Williangalvani/pfc/electronics.tex

\chapter{The Electronics} \label{chap:electronics}

In order for the aircraft to fly and navigate autonomously, onboard electronics are required, for both actuation, power source, and navigation. Some of the used electronics were already available, and were chosen for this reason. Others were chosen taking into account technical specifications, price, and availability.
	
\section{Propulsion}

Due to the familiarity and availability, the Mikrokopter Mk3638 Motor was chosen, paired with E-Max Simon 60A escs.

Experimental curves for the motor are available at Mikrokopter's website, and the relevant ones are reproduced in figure \ref{fig:motorcurves}. Each motor should give, on 16 V, around 1.9 kg of static thrust when paired to 12 inches propellers, up to 2.5 kg on 15 inches, while drawing 35 A, or about 560 W.

\begin{figure}[H]
\centering
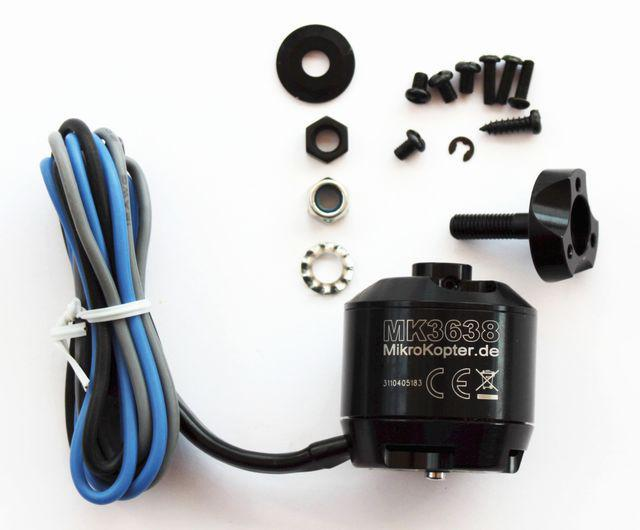
[picture p5: figs/mk3638.jpg]
  
  \caption{Mikrokopter MK3638 Brushless Motor.}
  \label{fig:mk3638}
\end{figure}

\begin{figure}[h]
  \centering
  \begin{subfigure}{0.9\textwidth}
    \centering
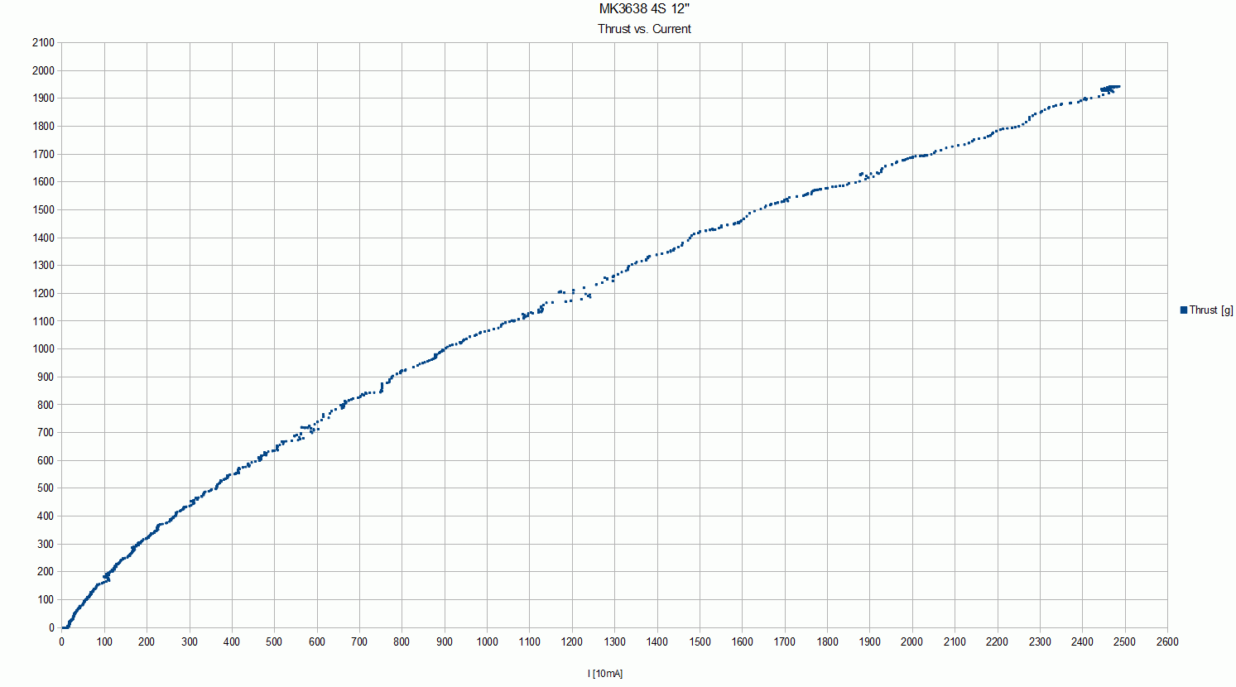
[picture p6: figs/curve12.png]
    
  
  \end{subfigure}
  
  \begin{subfigure}{0.9\textwidth}
    \centering
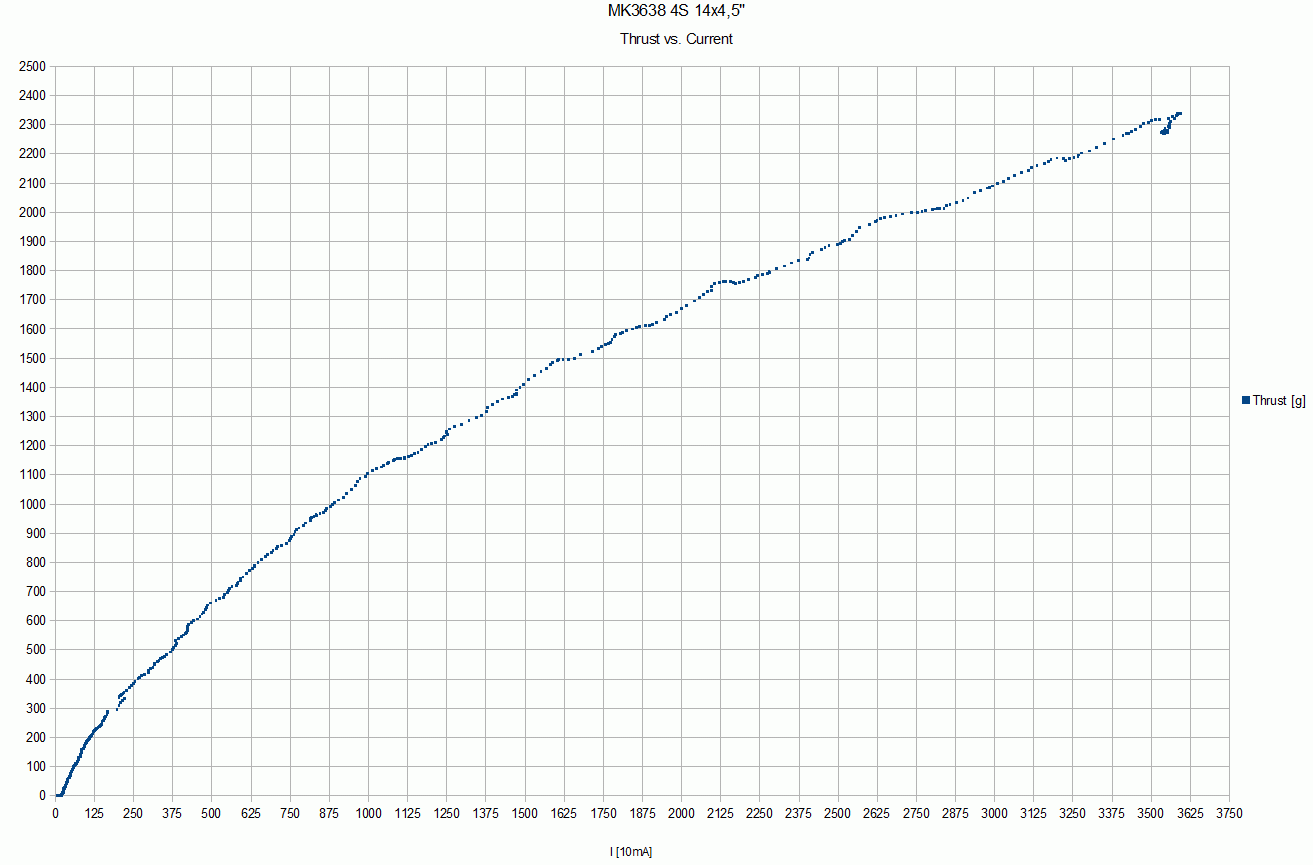
[picture p7: figs/curve15.png]
    

  \end{subfigure}
  \caption{Motor curves with 12 and 15 inches propellers. Source: mikrokopter.de}
  \label{fig:motorcurves}
\end{figure}

\begin{table}[H]
\centering
\begin{tabular}{|l|l|}
\hline
Lithium cell count 					& 3-6 \\ \hline
Load current      					& max. 20A \\ \hline
Maximum load current. (60 sec)		& 25 A \\ \hline
No-load speed 						& 770 rpm / V \\ \hline
Recommended Propeller Size 			& 10" .. 14" \\ \hline
Mechanical power					& 350 W \\ \hline
Thrust max.							& 2200 g \\ \hline
Wire length							& about 52 cm \\ \hline
Total weight (without cable)		& approx 100g \\ \hline
Dimensions							& h=35mm, d=38mm \\ \hline
Shaft diameter						& 4 mm \\ \hline
\end{tabular}
\caption{Mk3638 Brushless Motor Technical Specifications}\label{tab:mk3638}
\end{table}

As the airplane is aimed to weigh around 3 kg, each motor needs to pull at least 1500g for hovering, leaving a maneuvering margin of around 1 kg for each motor.

\section{Batteries}

As each motor can draw up to 25 A, the battery should be able to provide up to 50 A without issues.
The Batteries chosen are also the ones already in use by the company, Multistars 10000 mAh 10C, which, at 10 C rating, are able to sustain a constant draw of up to 100 A. 

Each battery weighs approximately 800 g and measures 160 x 65 x 36 mm.

\begin{table}[h]
\centering
\caption{Multistar 4s 10000mAh Battery Technical Specifications}
\label{tab:multistar}
\begin{tabular}{|l|l|}
\hline
Minimum Capacity		& 10000mAh \\ \hline
Configuration			& 4S1P / 14.8V / 4Cell \\ \hline
Constant Discharge		& 10C \\ \hline
Peak Discharge (10sec)	& 20C \\ \hline
Pack Weight				& 804g \\ \hline
Pack Size				& 160 x 65 x 36mm \\ \hline
Charge Plug				& JST-XH \\ \hline
Discharge Plug			& XT90 \\ \hline
\end{tabular}
\end{table}

\begin{figure}[H]
\centering
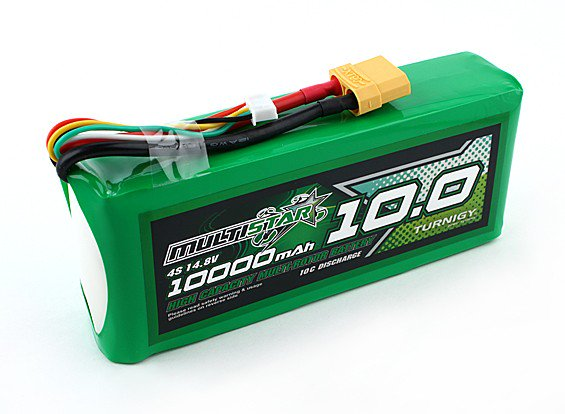
[picture p8: figs/battery.jpg]
  
  \caption{Multistar 4s 10000 mAh Lithium Polymer battery.}
  \label{fig:multistar}
\end{figure}

\section{The Servos and Control Surfaces}

The control surfaces must be slightly larger than usual for a flying wing, as on a tail-sitter a reasonable amount of air must be deflected on hover situation, while on most wings a steady airflow is assumed. It is suggested to have control surfaces taking up to 30\% of the chord of the wings. Since they are easily swappable, it was decided to start with smaller ones, with a 10 cm chord, and replace them if necessary.

The servos chosen were standard servos Savox SV-0220, linked to the elevon horns with a stiff wire. %\todo{add picture of horns}

\begin{figure}[H]
\centering
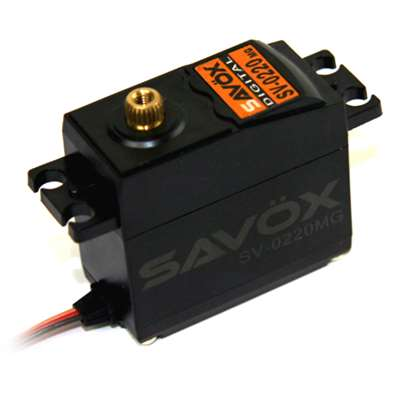
[picture p9: figs/servo.jpg]
  
  \caption{Savox SV-0220 servo.}
  \label{fig:sv-0220}
\end{figure}

\begin{table}[h]
\centering
\caption{SV-0220 Technical Specifications}
\label{my-label}
\begin{tabular}{|l|l|}
\hline
 Torque @ 6v &   6.5kg  \\ \hline
 Torque @ 7.4v & 8.0kg  \\ \hline
 Speed @ 6v    &  0.16 sec/60 deg  \\ \hline
 Speed @ 7.4v  &  0.13 sec/60 deg  \\ \hline
 Dimensions L x W x H (mm) &  40.7 x 20.0 x 37.0   \\ \hline
 Weight & 59.0g   \\ \hline
\end{tabular}
\end{table}

\section{The Flight Controller}

The multirotor had a huge boom in the last 10 years. In 2009 the first hobby-grade flight controller for multicopters was born, Rolf "KaptainKuk" Bakke's "KK board". Using a simple AVR controller and three gyroscopes, the board could control angular speed on three axis, enabling pilots to control the multirotors. It was programmed in AVR assembly and had individual PID controllers for each axis.
%
Shortly after, Alexinparis noticed the gyros on the Wii Motion + controller, and MultiWii was born. This project grew to support a variety of sensors and boards, and had an active development community, but has now saturated the AVR controller's capability.
%
Shortly after, still in 2010, DIY Drones released the open-source Arducopter, featuring more advanced flight modes, and even autonomous flight.  It did still involve compiling code and flashing it to the controller though.
%
In 2011, DJI started to get visibility with the NAZA controller, which showed remarkable stability, and later got upgraded with a GPS allowing the drone to return to home and hold position in the air. The controller was often sold with a standard frame and motors, which improved stability as the board was pre-tuned to the sold equipment.

Shortly after, DJI began to manufacture the DJI Phantom drones, which is now the main player in the market.
%
Nowadays, three major controllers coexist: MultiWii was ported to 32bits architecture processors and lives on as Baseflight and Cleanflight, mostly on quadcopter racing boards; DJI leads the aerial photography market with their phantom quadcopters; and on the autonomous fields, Ardupilot, PX4, Mikrokopter, and DJI are still competing for the better solutions.

The Flight Controller board chosen is a PixHawk. Both PX4 and ArduPilot stacks support this board. But Ardupilot is a more mature, tested, open, and community-based platform, and thus it was chosen here, running latest release of ArduPlane, where there's experimental support for tail-sitters.

\begin{figure}[H]
\centering
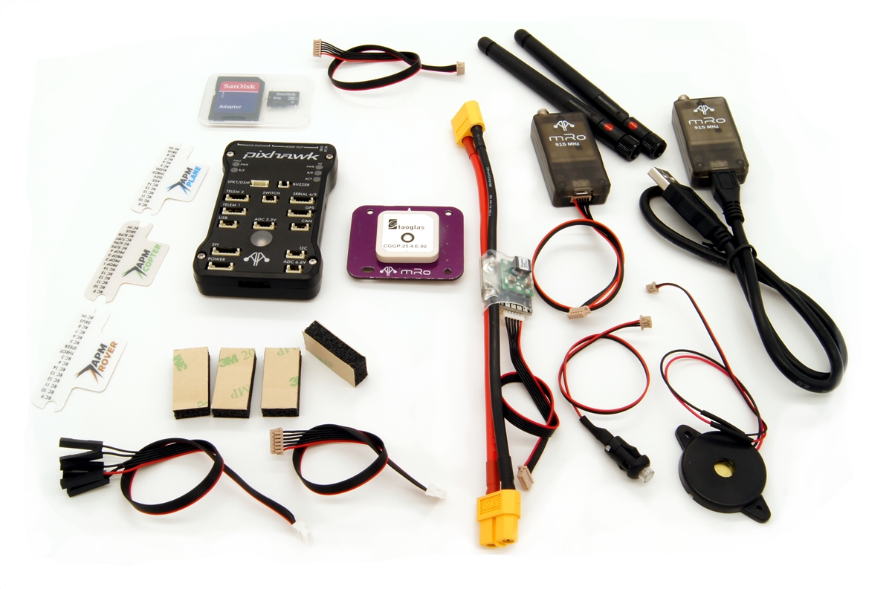
[picture p10: figs/pixhawk.jpg]
  
  \caption{Pixhawk flight controller and most peripherals. Source: Mrobotics}
  \label{fig:pixhawk}
\end{figure}

\section{The GPS}
The used GPS is an U-Blox M8N GPS receiver, coupled with an external compass sensor. The external compass is important because the high currents flowing close the Pixhawk affect the readings of the internal compasses.
%
It supports concurrent reception of up to 3 GNSS (Global Navigation Satellite Systems), GPS, Galileo, GLONASS and BeiDou.

It's precision is around 3 m, occasionally getting lower than 1 m\cite{m8ntest}.

\begin{figure}[H]
\centering
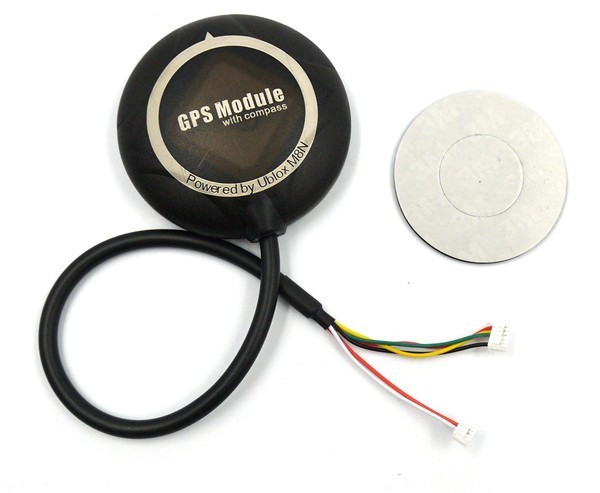
[picture p11: figs/m8n.jpg]
  
  \caption{M8N GPS receiver and external compass. Source: cooltoyz.co.uk}
  \label{fig:m8n}
\end{figure}

\section{The Telemetry}

The telemetry system provides a serial (UART) connection to the aircraft, via a radio system.
%
The one used can be seen on the top right corner of figure \ref{fig:pixhawk} and is a 900Mhz radio modem.
%
The telemetry allows real-time reading of parameters and attitude, as well as writing them for setup and tuning.

\section{The Radio Control System}

The used Radio System is a 2.4Ghz radio by Turnigy, the Turnigy 9x.
%
This radio uses fast frequency hopping to avoid interference, and has a reported range of up to 3 km \cite{range9x}.
%
The radio was modded\cite{t9xmod} and the firmware was replaced by the open-source OpenTX \cite{opentx}, which provides much more flexibility to the system, such as custom mixes, switches, automatic functions, periodic functions, and telemetry capabilities.

\begin{figure}[H]
\centering
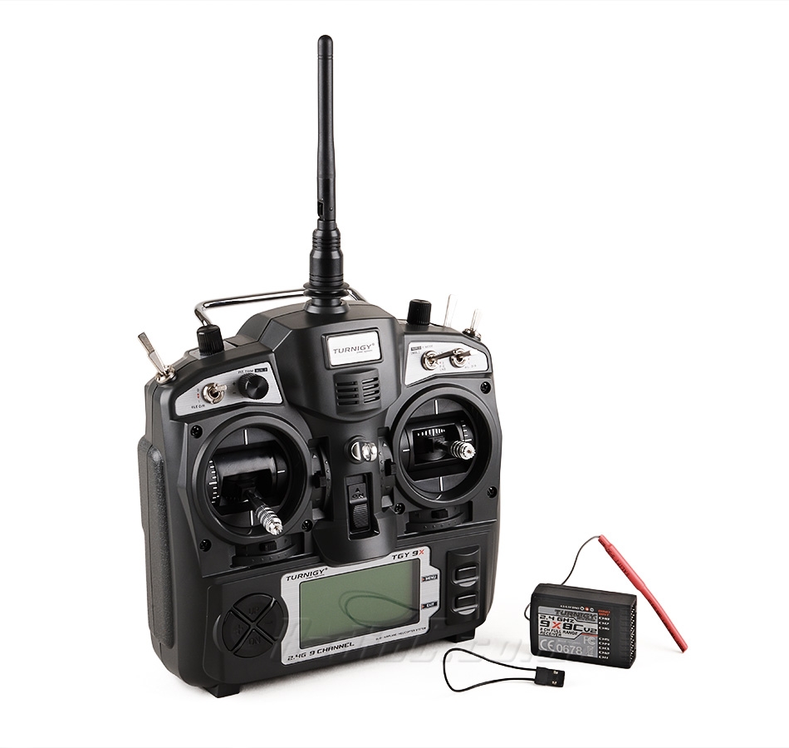
[picture p12: figs/t9x.jpg]
  
  \caption{The Turnigy 9X Radio System. Source: radioc.co.uk}
  \label{fig:t9x}
\end{figure}

\section{The Camera}

In order to take pictures for the aerophotogrammetry, a camera is needed. As the company is also working on a RTK\footnote{Real Time Kinematics, a system that improves GPS localization giving millimetric precision.} system, a compatible camera is required.

Sony's DSC HX60V was chosen due to its sensor size, which at 55 mm is able to provide a broad field of view; for it's weight, relatively low at 272 g; presence of Multi protocol for communication with flight controllers; and external flash support, which can be used to read the precise time when a picture was taken. The time can then be synced to the current GPS position and the aircraft's attitude.

\begin{figure}[H]
\centering
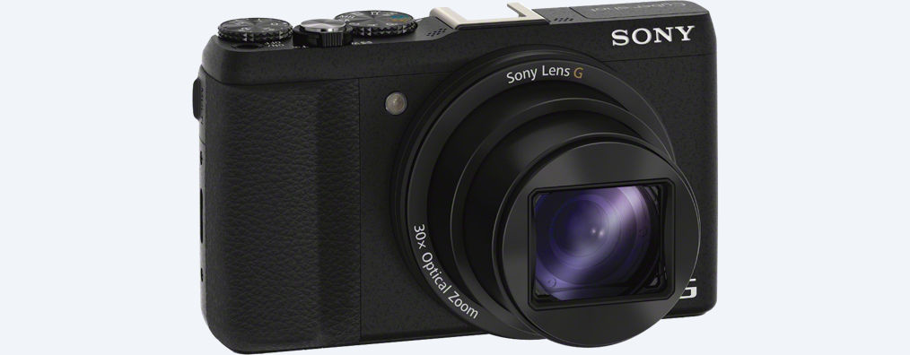
[picture p13: figs/camera.jpg]
  
  \caption{Sony DSC-HX60V Camera. Source: sony.pt}
  \label{fig:camera}
\end{figure}

%%%%%%%%%%%%%%%%%%%
