Williangalvani/pfc/assessment.tex

\chapter{Assessment} \label{chap:assessment}

The assessment was planned with incremental tests. First, the VTOL capabilities would be tested, with stabilized flights, then the position hold (loiter), followed by autonomous taking-off, then landing. With the VTOL modes working, it would be time to test the transition to forward flight, the flight itself, and the transition back into VTOL mode.

The tests performed are better described in the following sections, along with their results.

\section{Tethered Attitude Control Test}

To test the attitude control and stabilization, the prototype was hang by a rope, so it's range of movement was restricted, and it was safer to test indoors.
%
The first tests were qualitative. The wing was armed on the QStabilize mode, where the gyroscope and accelerometer are used to try to maintain the aircraft leveled in VTOL mode (propellers spinning parallel to ground).
%
The expected result was that the elevons should move trying to stop the movement, even without propellers on the motors (again, for safety reasons).
%
The aircraft successfully reacted to disturbances on it's attitude by moving the control surfaces appropriately.
% 

This test was repeated with propellers, perturbations were applied to the wing by manually trying to turn it on each of the three axis. 
%
Each axis was tested at least twice on each direction, and the aircraft reacted re-orientating itself successfully on all occasions.

\section{Un-tethered Attitude Control Test} 

For this test, the wing was taken to an open field in the university.
%
For the take-off, it had to be oriented so the wind blew parallel to it's surface, so that the wind didn't flip it over.
%
Take-off can't be too slow, as the winglets adhere to the ground and can cause the aircraft to tip over.
%
Once in the air, the controls and stabilization worked well, but once the wind hit the aircraft, it turned perpendicular to the direction of said wind, and the control authority was not enough for both stabilizing flight and turning the yaw axis.
%
While this problem limits the yaw controllability in VTOL mode, the position control is not necessarily affected, as the aircraft can still move in a mixed attitude between VTOL and fixed wing, inclined against the wind and maintaining position.
%

This could possibly be fixed by increasing the winglets area, however this also increases the area the wind hits, and needs more testing to verify.
%
Another possibility is tweaking the pitch angle limits, which by default are $\pm 30\degree$, not enough to fight the wind in this case.

The flight path can be seen in figure \ref{fig:flight1-3d}, and an in-flight photo in figure \ref{fig:flight1-photo}. The video is available on youtube\cite{flight1}.
%
No attempt at transitioning to fixed-wing mode was made at this flight due to the reduced space available, which made the pilot feel unsafe.

\begin{figure}[H]
\centering
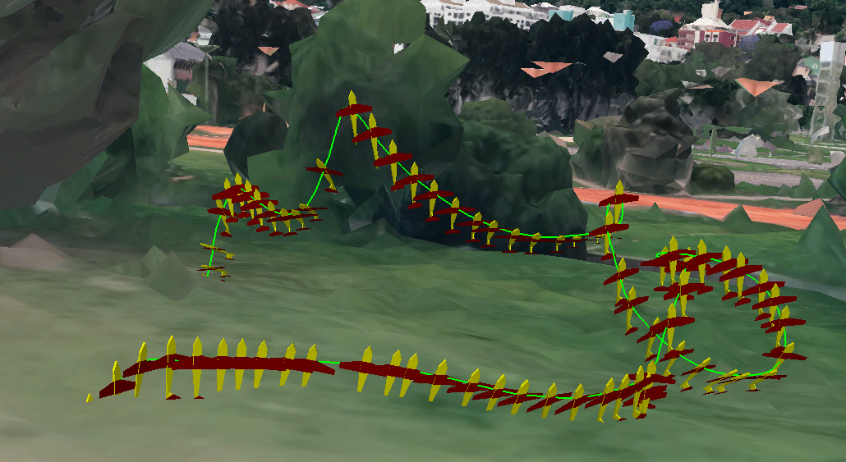
[picture p14: figs/flight1-3d.png]
  
  \caption{Visualization of first test flight.}
  \label{fig:flight1-3d}
\end{figure}018/01/16/novarum-sky-on-the-up/
	
	\begin{figure}[H]
\centering
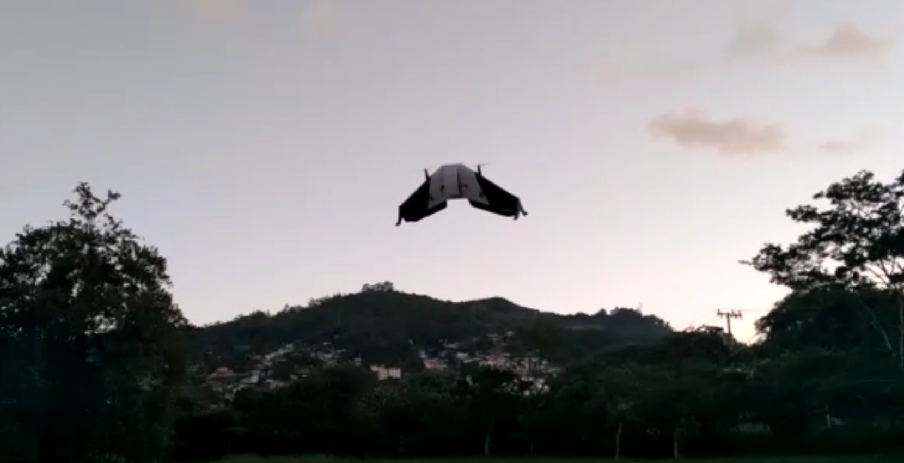
[picture p15: figs/flight1-photo.png]
  
  \caption{Photo of first test flight.}
  \label{fig:flight1-photo}
\end{figure}

\section{Position Hold}
The next test was taking-off and landing autonomously. Due to the winds and undersized landing gear, the aircraft was positioned with the surface again parallel to the wind flow.

The autonomous take-off however, tried to take-off too slowly, and the winglet/landing gear grip to the grass limited pitch control prior to taking-off, causing the wing to tip over. The solution was to take-off manually, in QStabilize (Quadplane Stabilize) mode, then switching to QLoiter. Five of such flights were attempted. The results are on Table \ref{table:loiter}.
Some of these tests are available online\cite{test2}.

While most of the results were good, a roll oscillation was present on some of the flights, causing instability and forced landings.
The problem appears to be caused by the navigation controller, as the roll("ATT.Roll") actually follows the roll setpoint("ATT.DesRoll"), which is oscillating, as seem on picture \ref{fig:rollOscillation}. This could mean that the navigation controller is oscillating fast around the given point, with increasingly high amplitude, requiring further tuning of its parameters. 

	\begin{figure}
\centering
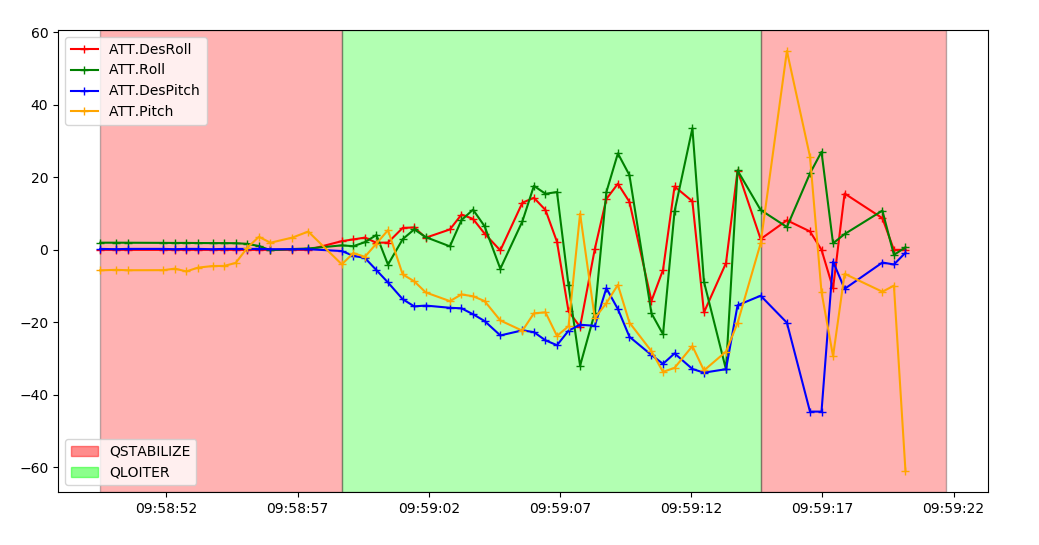
[picture p16: figs/rolloscillation.png]
  
  \caption{Visualization of logged attitude control.}
  \label{fig:rollOscillation}
\end{figure}

\begin{table}[]
\centering

\resizebox{\textwidth}{!}{%
\begin{tabular}{@{}rrrrl@{}}

Test \# & Flight Time (s) & \begin{tabular}[c]{@{}r@{}}Position \\ Hold Radius (m)\end{tabular} & \begin{tabular}[c]{@{}r@{}}Maximum \\ Altitude (m)\end{tabular} & Notes              \\ \midrule
1       & 47              & 1.5                                                                 & 14.4                                                            &                    \\
2       & 47              & 8.1                                                                 & 12.0                                                            & Roll oscillation    \\
3       & 56              & 3.0                                                                 & 13.1                                                            &                    \\
4       & 37              & 3.7                                                                 & 4.3                                                             & Roll oscillation    \\
5       & 51              & 7.5                                                                 & 13.9                                                            & Pushed by the wind
\end{tabular}%
}
\caption{Loiter tests summary.}\label{table:loiter}
\end{table}

\section{Test Conclusions}

Although not all tests could be done on time, the VTOL capabilities were tested and the results were very satisfactory, with only two minor issues. The first issue is that, on an autonomous take-off, the motors speed up too slowly, taking the aircraft off balance before it gets off the ground, where its control surfaces are not very effective, as the friction holds the winglets in place, impairing the pitch control. The second one is that the winglets/landing gear needs to be a little larger and better attached to the aircraft, otherwise it tips over during landing.

Further tests need to be made on the transition into forward flight and on the forward flight itself.
