Williangalvani/pfc/flight.tex

\chapter{Flight Mechanics and Design} \label{chap:FlightMechanics}

\section{Brief Introduction to Flight Mechanics}

In order to achieve proper flight, a vehicle needs an upwards force and means of maneuverability. The former is usually generated by the means of a propeller, while the latter can be either the result of spinning propellers or using control surfaces to deflect the passing air's movement, causing a force towards the opposite direction. 

Flight mechanics is a field of mechanics which deals with the study of vehicle trajectories, performance, stability, and aerodynamic
control.

\section{Fixed-Wing Mechanics}

In fixed-winged aircraft, the air flowing through the wings generates a pressure differential, which lowers the pressure on top of the wing and generates a force called \texit{lift}. This force is responsible for canceling the gravitational pull and keeping the vehicle aloft in the air.

In a simplified explanation, two main principles are responsible for generating lift:

\subsection{Flow deflection and Newton's laws}

Most wings have an angle of attack (to be hereafter called $\alpha$) such that $\alpha > 0$, which means the air passing through it gets deflected down. According to Newton's second law, an opposite force is necessary on the wing. That force is the generated lift.

\subsection{Increased flow speed and Bernoulli's principle}

Bernoulli's principle states that within a steady airflow of constant energy, when the air flows through a region of lower pressure it speeds up and vice versa. This implies there is a direct mathematical relationship between the pressure and the speed, meaning if one knows the speed at all points within the airflow, one can calculate the pressure and vice versa. For a cambered airfoil (where the chord at the top is longer that the chord at the bottom) the air needs to take a longer path, moving faster, thus lowering the pressure on the top, and generating lift.

\subsection{Airfoil Shape}
How much lift is generated depends on the chosen airfoil.
%
A cambered airfoil (longer chord on the upper surface than in the lower one) generates lift even when the angle of attack $\alpha$ is zero.
Symmetric airfoils need a positive angle, and the lift is generated by deflecting the air downwards.
Other properties that depend on the airfoil shape are the drag (air force pushing against the direction of movement) and angular moment it creates on the aircraft. 

\subsection{The Coordinate System and Nomenclature}

The coordinate system, when dealing with the fixed-wing and VTOL modes, is as shown in figures \ref{fig:coords1} and \ref{fig:coords2}.

\begin{figure}[h]
\centering
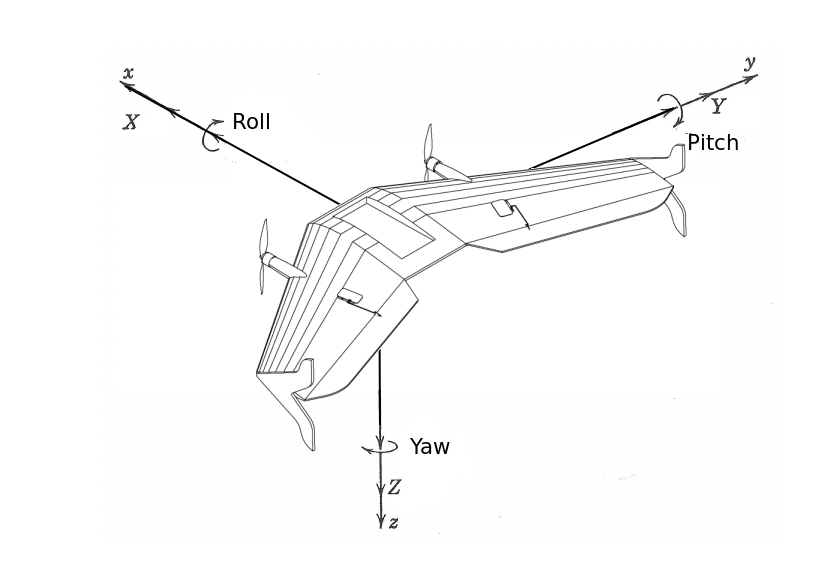
[picture p22: figs/axisfixedwing.png]
  
  \caption{Coordinates system and relevant variables in fixed wing mode.}
  \label{fig:coords1}
\end{figure}

\begin{figure}[h]
\centering
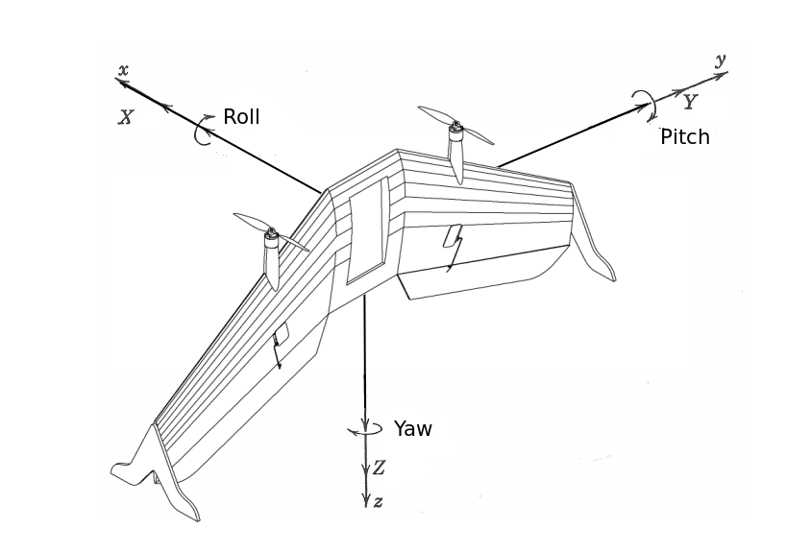
[picture p23: figs/axisvtol.png]
  
  \caption{Coordinates system and relevant variables in VTOL mode.}
  \label{fig:coords2}
\end{figure}

Where:

\begin{itemize}

\item $x$, $y$, and $z$ are the coordinates, with the origin in the vehicle's center of mass.
%\item $u$, $v$, and $w$ are the linear velocities in each of the $x$, $y$, and $z$ coordinates, respectively.
\item $X$, $Y$, and $Z$ are the components of the aerodynamic force in each of the $x$, $y$, and $z$ coordinates, respectively.
\item Roll, Pitch and Yaw respectively represent the rotations around the X, Y, and Z axis.
\item Between VTOL and Fixed Wing mode, Yaw is Switched with Roll, as the controls switch to Multicopter mode, which usually have the rotors parallel to the ground.
%\item $p$, $q$, and $r$ are the linear velocities in each of the $x$, $y$, and $z$ coordinates, respectively.
%\item $u$, $v$, and $w$ are the linear velocities in each of the $x$, $y$, and $z$ coordinates, respectively.
%\item  Although not indicated in the figure, the variables $\phi$, $\theta$, $\psi$ represent the angular rotations,
%relative to the equilibrium state, about the x, y, and z axes, respectively. Thus, $p=\dot{\phi}$, $q = \dot{theta}$
%and $r = \dot{\psi}$ where the dots represent time derivatives.

%$\phi$, $\theta$, and $\psi$ can also be referred, respectively, as \textit{roll}, \textit{pitch}, and \textit{yaw}.

\end{itemize}

\section{VTOL Mechanics}

When in VTOL mode, the coordinate system used is similar to that in a conventional multirotor, with $Z$ pointing up parallel to the motors' axis, and $X$ going through the fuselage, pointing away from the belly of the aircraft.

The mechanics involved in vertical take-offs and landings are slightly different. The lift generated becomes meaningless, no more than a small perturbation to the system. The generated thrust becomes directly responsible for vertical motion and roll control, while the control surfaces can redirect the airflow allowing control of yaw and pitch.

An approximate model can be seen on \cite{7487466}, where a wind-tunnel was used to find the parameters. As this work does not focus on the dynamics or control itself, it is not detailed here.

\section{XFLR5}

XFLR5\cite{xflr5} is an analysis tool for airfoils, wings and planes operating at low Reynolds Numbers. It includes:
\begin{itemize}

\item XFoil's Direct and Inverse analysis capabilities;
\item Wing design and analysis capabilities based on the Lifting Line Theory, on the Vortex Lattice Method, and on a 3D Panel Method.

This tools enables the iterative design and analysis of multiple aircraft configurations.

%\todo{elaborar aqui}

\end{itemize}

\section{Design}

The chosen design is the one of a flying wing, a fuselage-less aircraft made of a wing, propulsion system, and control surfaces. The reasons are because of a simpler and sturdier mechanical structure, besides the possibility of the VTOL configuration.

\subsection{Preliminar Design}

As a starting point, a wing with a central hub and 2 semi-wings ending in symmetrical winglets was designed. The ZAGI12 airfoil was chosen due to its good soaring capabilities and low stall speed.
%\todo{citation needed}.

With the airfoil chosen, its characteristics were calculated with the aid of XFOIL, an airfoil analysis tool built into XFLR5.

\begin{figure}[h]
\centering
  
  \caption{Zagi 12 airfoil.}
  \label{fig:zagi12}
\end{figure}

These characteristics plots can be seen in figure \ref{fig:zagi12polares}.
%

From this figure, the point with the highest Cl/Cd ratio - the theoretical point with the best lift to drag ratio, and therefore best gliding performance - can be found. It can also be seen that the airfoil's moment "pulls" it into this better Cl/Cd ratio, allowing the aircraft to fly into this ideal condition without deflection of the control surfaces, which would cause aerodynamical losses.

\begin{figure}
\centering
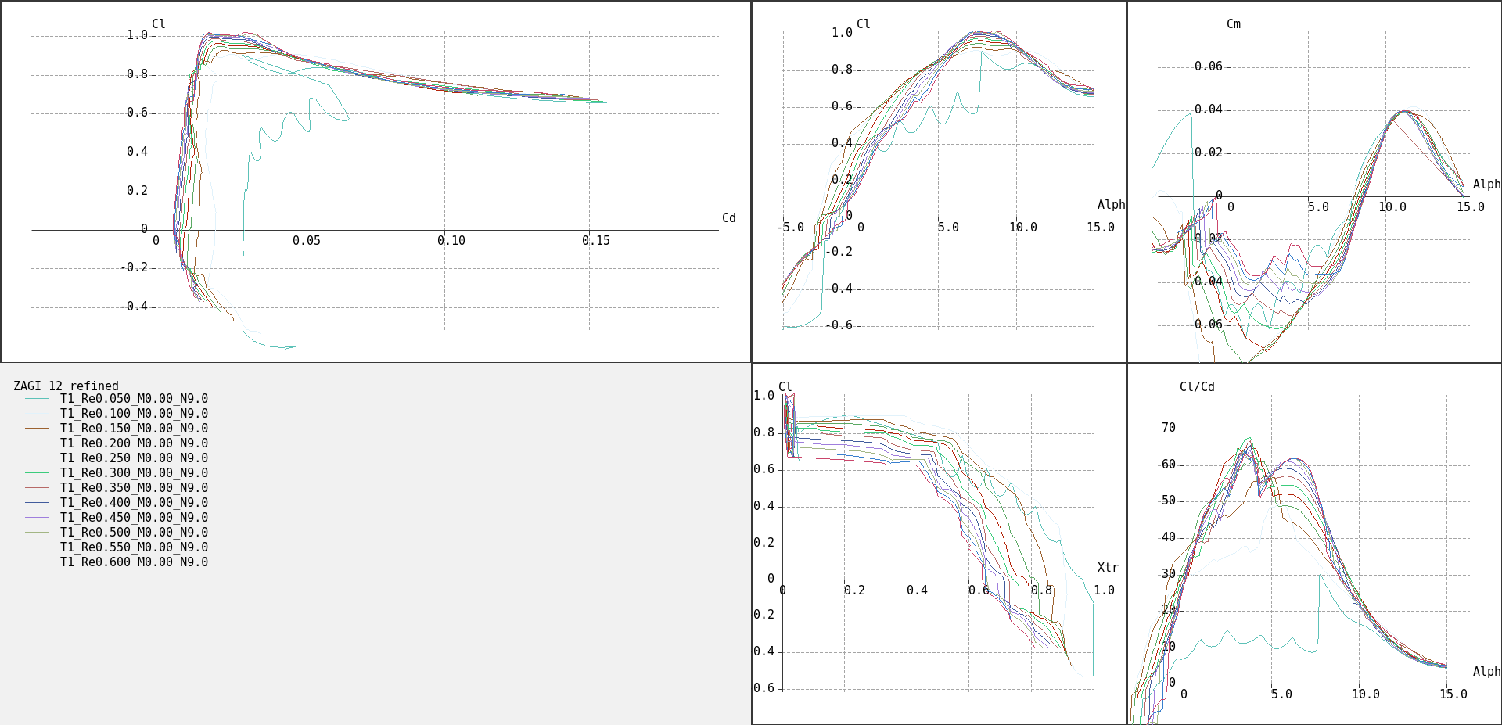
[picture p24: figs/polares.png]
	  
  \caption{Zagi 12 characteristics}
  \label{fig:zagi12polares}
\end{figure}

With that data, the main body was conceived, as seen in figure \ref{fig:preliminar}. With this CAD tool we can then analyze the performance of the aircraft as a whole. This gives us the same data as the airfoils', but for the whole craft, as seen in figure \ref{fig:craftpolar}.

More data can be inferred from these graphs. From figure \ref{fig:zagi12polares} it can be seen that the highest $C_l$, or Lift Coefficient, is obtained around $\alpha = 8\deg$, which, possibly by design of the airfoil, is also the zone with a higher $C_l/C_d$, or \textit{lift-to-drag ratio} maximizing the gliding distance. 
%It's also notable tat the $C_m  \times \alpha$ plot crosses 0 around the the same $8\deg$, meaning the profile is generally trying to point at that angle.

\begin{figure}
\centering
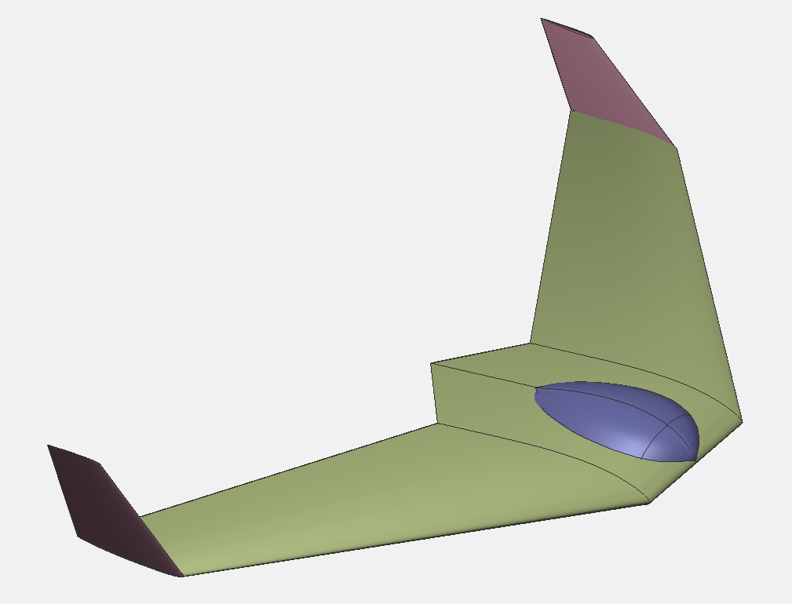
[picture p25: figs/preliminar.png]
  
  \caption{First concept of the aircraft.}
  \label{fig:preliminar}
\end{figure}

From \ref{fig:craftpolar}, it is noticeable that without command inputs, the aircraft tends to point the nose down $ 2 \degree $, as its maximum lift-to-drag coefficient is at $8 \deg$, the center of gravity can be adjusted to make the cm/alpha angular coeficient close to 0, meaning the aircraft is marginally stable, in a way that only a small elevon input is required to turn it towards the best alpha, reaching it's maximum lift-to-drag. This change can, however, decrease the stability of the aircraft and increase the chances of a stall\footnote{A stall is a condition in aerodynamics and aviation wherein the angle of attack increases beyond a certain point such that lift begins to decrease. This can lead an aircraft to crash.}. However, as the system is running on a closed loop, this is not a problem.

The flight time can be estimated by analyzing the motor power consumption during cruise flight.

First, as we assume $ 3 kg $ of weight, we need to find the angle $\alpha$ that, at $15 m/s$, produces $3kg$ of lift.

The Lift formula is the following:
\begin{equation}
L=\tfrac{1}{2}\rho v^{2}SC_{L}
\end{equation}
Where $L$ is the produced lift in Newtons, $\rho$ is the air density in $kg/m^3$, $S$ is the wing's surface area in $m^2$, and $C_L$ is the dimensionless lift coefficient.

Plugging the data into the equation and solving for $C_L$, we find that the incidence angle $\alpha = 0.83$, which, looking at the $C_D \times \alpha$ plot, results in a drag coefficient $C_D$ of 0.08.

With the drag coefficient $C_D$, we can calculate the estimated drag force $F_D$:

\begin{equation}
F_{D}=\tfrac{1}{2}\rho v^{2} S C_{D}
\end{equation}

This results in a drag of approximately $8.84N$ ( $900 gf$).

Assuming there are manufacturing issues and other imperfections, we assume a drag of $1.5 kgf$. Such drag would mean that each motor needs to produce around $ 750 gf$ of thrust. According to figure \ref{fig:motorcurves}, the motor needs 
approximately $6 A$ to produce this thrust, resulting in $\frac{10Ah}{12A}$ hours of flight, or 50 minutes. This is assuming 70\% extra drag than simulated.

A slower flying speed should also help with power consumption, as the required alpha will be higher, resulting in a better lift-to-drag coefficient.

\begin{figure}
\centering
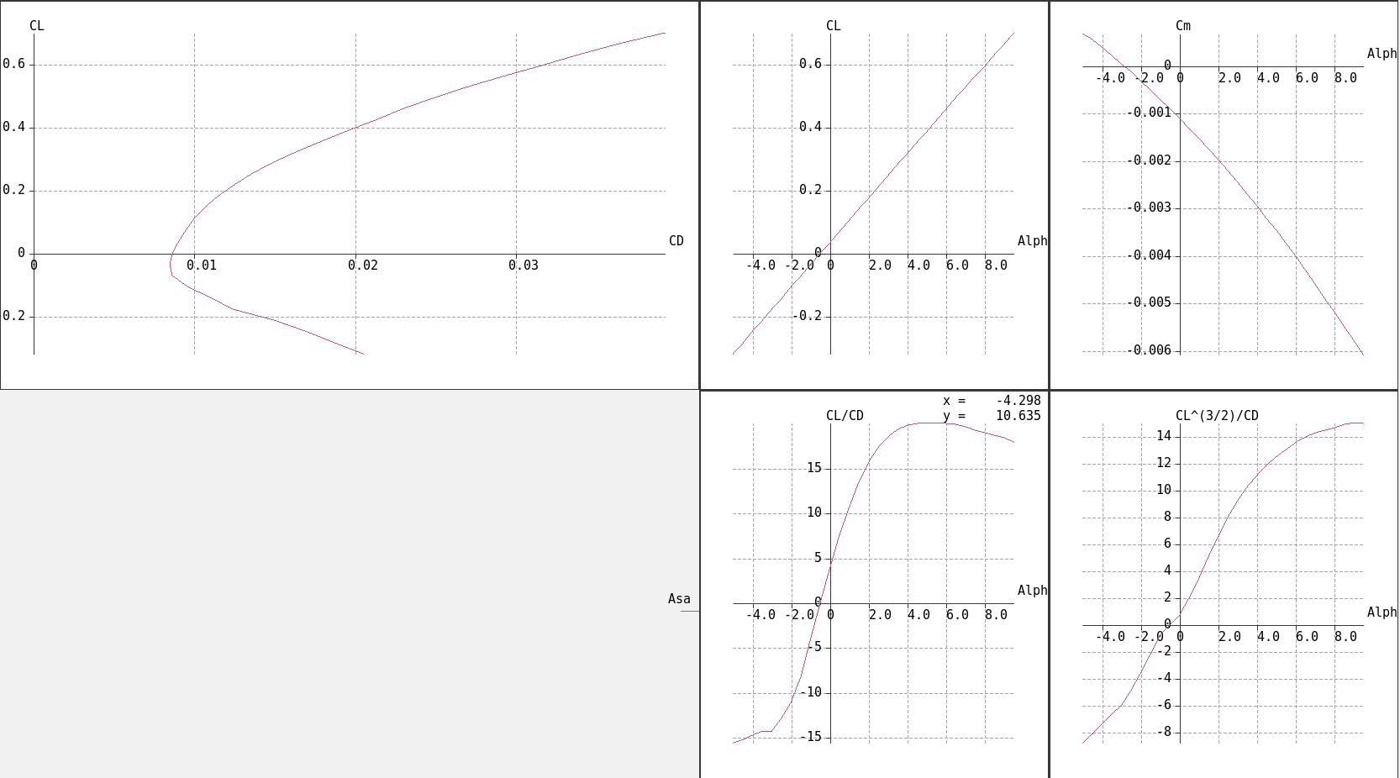
[picture p26: figs/craftpolar2.png]
  
  \caption{Flight characteristics of the final aircraft design.}
  \label{fig:craftpolar}
\end{figure}

\subsection{Final Design}

Due to building issues and the desire to maximize both effective payload and flight autonomy, the design was simplified, extending the chord back on the center of the wings, as seem in figures \ref{fig:finalrender} - \ref{fig:finalrendertop}.
The electronics bay was embedded into the main section, reducing the aerodynamical cross-section, thus reducing drag. The whole design was then assembled on Autodesk Inventor Professional prior the manufacturing of the prototype.

\begin{figure}
\centering
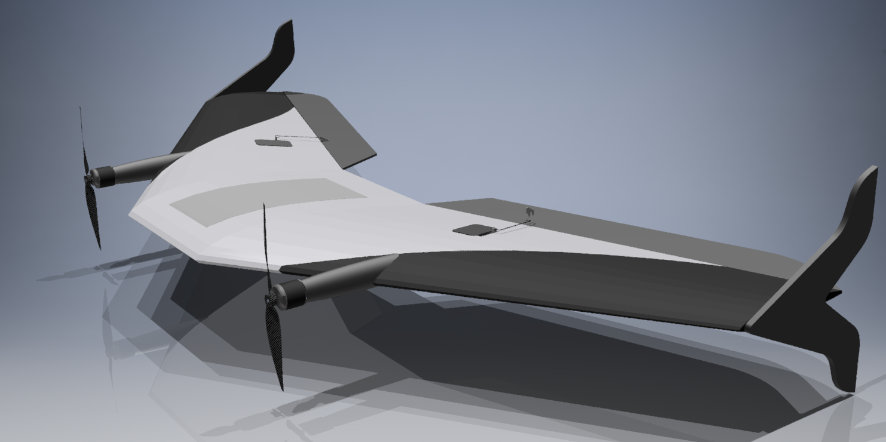
[picture p27: figs/finalrender.png]
  
  \caption{Final design of the aircraft.}
  \label{fig:finalrender}
\end{figure}

\begin{figure}
\centering
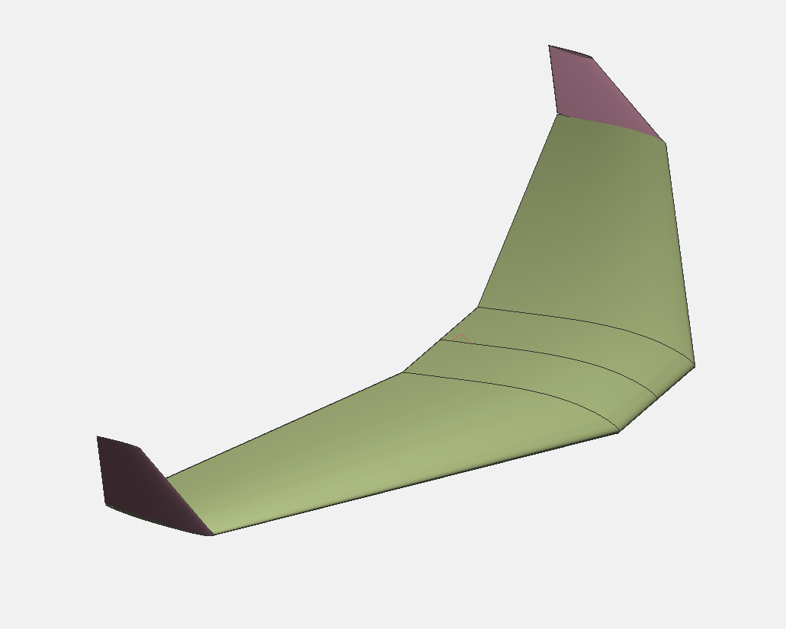
[picture p28: figs/final.png]
  
  \caption{Final design of the aircraft, on XFLR5.}
  \label{fig:final}
\end{figure}

\begin{figure}
\centering
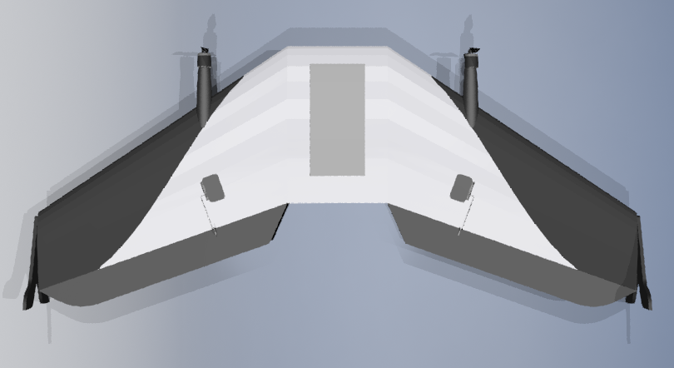
[picture p29: figs/finalrendertop.png]
  
  \caption{Final design of the aircraft, top view.}
  \label{fig:finalrendertop}
\end{figure}

%%%%%%%%%%%%%%%
