Williangalvani/pfc/prototyping.tex

\chapter{Prototyping} \label{chap:prototyping}

As in any product development, a few protoypes were developed.
First a smaller, 50 cm wingspan aircraft with no airfoil was assembled to test and tune the flight controllers. The reduced version also enabled testing in close spaces and proximity with people with reduced danger.

With the reduced prototype proven, the larger one, photography-ready was developed. This second prototype is closer to the final desired product, and can be used as such.

Both prototypes are described, as well as their assemblies, in the next sections.

\section{Reduced Scale Prototype}

A reduced prototype was used for preliminary tests of the flight controller and control systems.

Mechanically, this prototype consists of a foam board, two motors, and two control surfaces.

Smaller electronics are used as well. The servos are Turnigy 9 gram servos, the motors are AXN Floater-Jet 2208 2150KV brushless motors, the Escs are HobbyKing's RedBrick 30A ESCs, and the battery a Zippy Compact 3s 1000mah 35C.

The control surfaces were taped to the main body, and linked to the servos by a wire and plastic horn.

The motors had a custom mount 3D-Printed and fitted into the foam.

For the tests and tuning, the prototype had a hook on top, so it could be hanged from the ceiling to avoid hitting the floor and walls during the tests.

The first prototype and its components can be seen in figure \ref{fig:smallprototypeparts}

\begin{figure}[H]
\centering
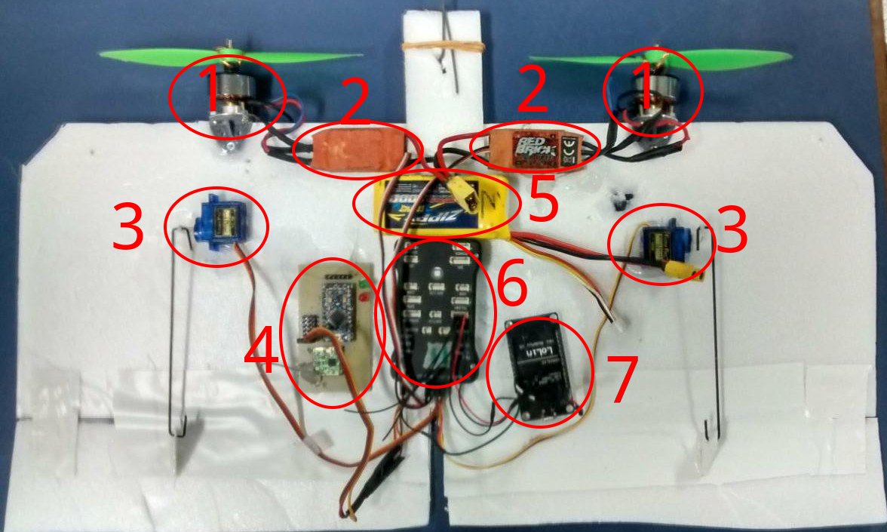
[picture p30: figs/reducedprototype.jpg]
  
  \caption{Reduced Prototype and parts:\\
   1 - Motors and 3D-printed mounts\\
   2 - HobbyKing RedBrick 30A ESCs\\
   3 - Turnigy Pro 9 gram servos\\
   4 - Diy OpenLRS 433 MHz receiver\\
   5 - Zippy Compact 3s 1000mAh 35C lithium-polymer battery\\
   6 - Pixhawk controller\\
   7 - ESP-8266 board for telemetry}
  \label{fig:smallprototypeparts}
\end{figure}

\section{Large Prototype}

For the larger prototype, standard RC building and fast prototyping technologies were used.
The Zag12 airfoil at root was 3D printed in 3 parts (figure \ref{fig:printedairfoil}) then joined and insulated from the hot-wire heat with aluminum foil. For the trapezoidal wings, one side of the wire was tied to a fixed point, in such way that, if the airfoil was a circle, the wire would cut a cone on the foam. This enabled the cut of the trapezoidal wings out of foam. For the center section, two profiles were 3D-printed. their perimeters were then marked with numbers, in such way that two people, one on each side, could coordinate the hot-wire cutting process.

\begin{figure}[H]
\centering
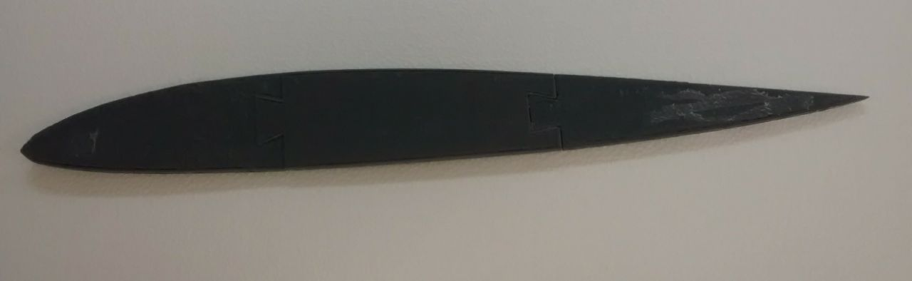
[picture p31: figs/printedairfoil.png]
  
  \caption{3D Printed Airfoil}
  \label{fig:printedairfoil}
\end{figure}

This process isn't perfect for the trailing edge, so some of it needs to be removed, which later gets replaced by the elevons.

The cut foam then needs to be sanded down to remove imperfections.
The half-wings are then joined with hot glue, and fiber glass spars are used to reinforce the structure.

From this point, the sections can be joined permanently or spars can be used to quickly assemble them.

With the three sections properly cut, they are glued together and sanded, and glass fiber rods were embedded and glued into the structure, two on the top and two on the bottom.

With the main structure assembled, the servos were embedded into the structure. A pocket was carved with hot wire, and two nut-holding 3D-printed parts were embedded deep into the foam and used to screw the top cover, as seen in figure \ref{fig:servomount}.

\begin{figure}[H]
\centering
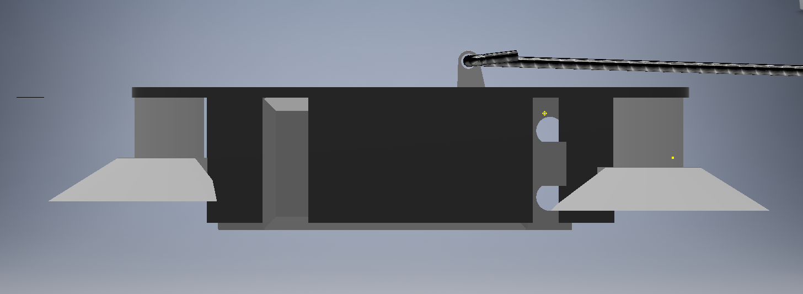
[picture p32: figs/nutholder1.png]
  
  \caption{3D-printed servo mount structure.}
  \label{fig:servomount}
\end{figure}

\begin{figure}[H]
\centering
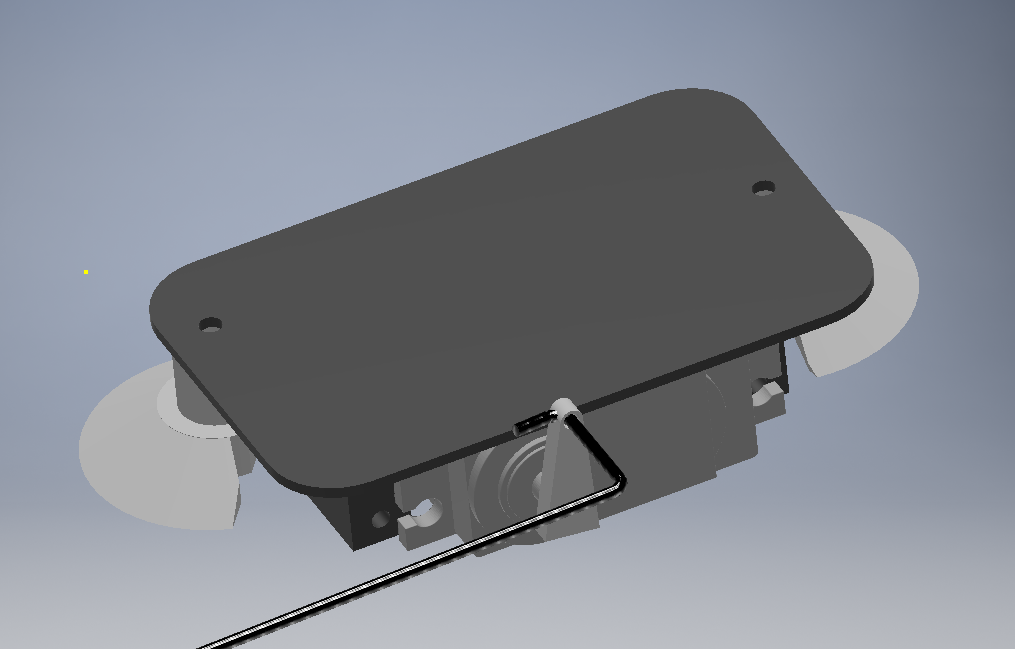
[picture p33: figs/nutholder2.png]
  
  \caption{3D-printed servo mount structure.}
  \label{fig:servomount2}
\end{figure}

The main structure was then covered in vinyl, for aesthetical and structural purposes (the tension on the vinyl helps making the structure stiffer). Vinyl is a material that shrinks when heated, which makes it tension itself over its surface.

The motor mounts were designed so they fit perfectly on the wing profile, and 3D-printed, glued and screwed into the main wing.
The mounts can be seen in figure \ref{fig:motormount}

\begin{figure}[H]
\centering
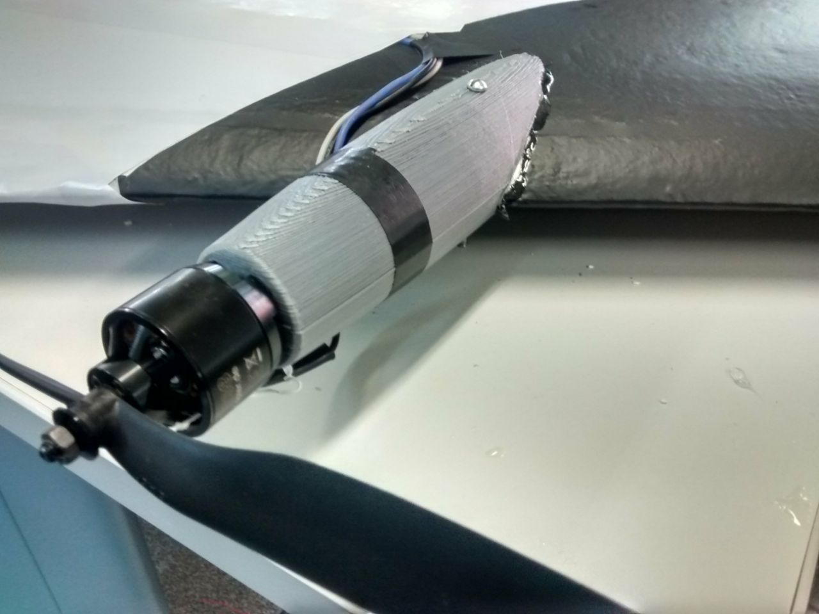
[picture p34: figs/3dprintedmount.png]
  
  \caption{3D-printed motor mount structure.}
  \label{fig:motormount}
\end{figure}

 \begin{figure}
\centering
\begin{subfigure}{.5\textwidth}
  \centering
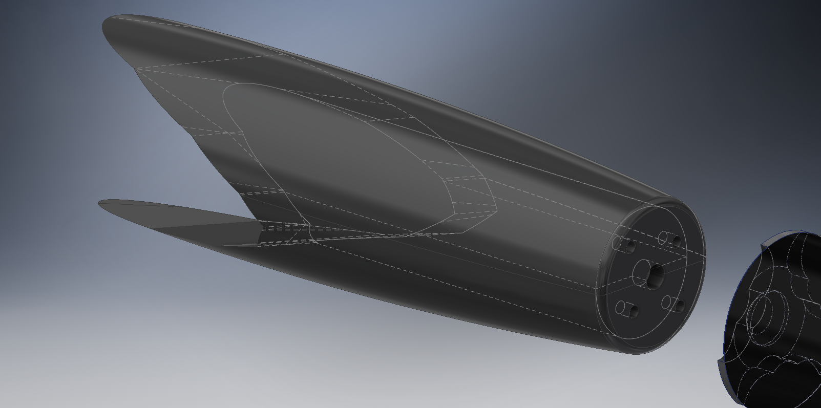
[picture p35: figs/pods1.png]
  
  %\caption{Todos os passos do Nelder-Mead}
  
\end{subfigure}%
\begin{subfigure}{.5\textwidth}
  \centering
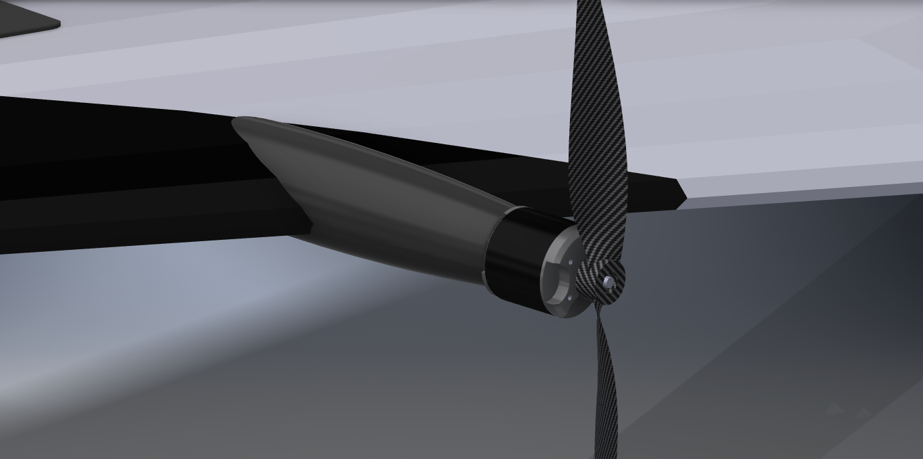
[picture p36: figs/pods2.png]
  
  %\caption{Pontos avaliados pelo Nelder-Mead aplicado em um parabolóide.}

\end{subfigure}
\caption{Motor pod design.}
\label{fig:pod}
\end{figure}

The electronics bay was cut using hotwire and carved with a knife. A hot air blower was used to finish the inner surface. The components were placed keeping in mind flexibility to change the camera and batteries without affecting the center of gravity too
much, maintaining approximately the same flight characteristics.

The flight controller was glued with vibration-dampening material. The battery was attached with velcro, and the remaining components are either glued or screwed in place. Special care was taken into keeping the magnetometers away from the motor and battery wires, as the induced magnetic field can adversely affect the magnetic readings.

The hinges were made using a type of fibrous tape. The tape was cut into pieces and glued onto itself, in such way that the piece of tape first sticks to the top of one section and to the bottom of the other section, taking care so that it does not stick to either section at their junction. These compound tapes are then glued in pairs, with one piece sticking to the bottom of the wing and the top of the elevon, and the other to the top of the wing and the bottom of the elevon. \ref{fig:hinges}.

\begin{figure}[H]
\centering
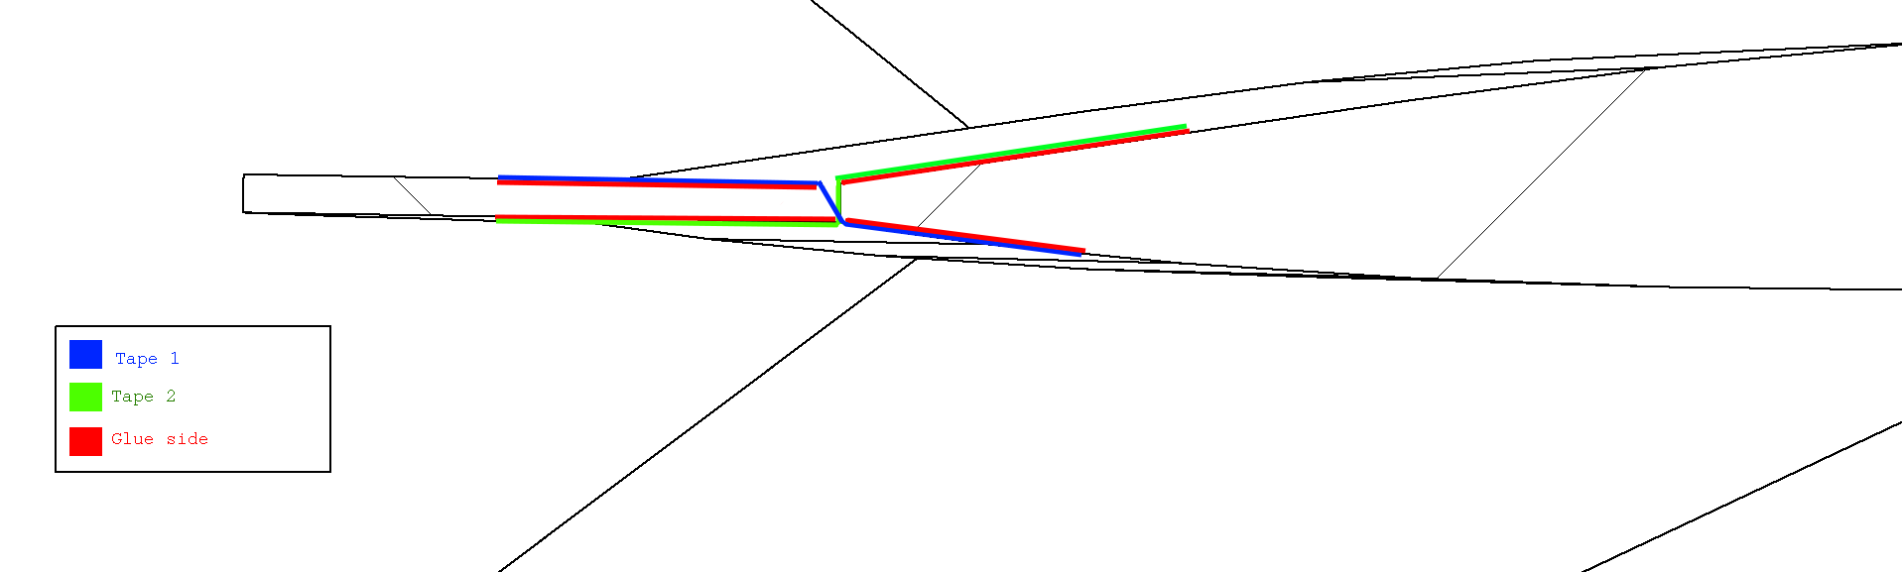
[picture p37: figs/elevons2.png]
  
  \caption{hinges setup.}
  \label{fig:hinges}
\end{figure}

The winglets usually have only an aerodynamic function, as they increase the yaw ($Z$) stability and help avoid wing tip vortexes, but here they also need to work as a landing gear in VTOL mode.

As they need to let go after certain amount of force is exerted, and need to be removable to aid in transportation, a magnetic system was idealized. On the wingtip there's a 3D-printed profile with slots for the magnets, and the mirrored profile is also present on the winglet. This profile can be seen in figure \ref{fig:magnetcoupler}. This profile made sure that four pairs of magnets touch on each winglet.However, this design allows slipping between the profiles, so Velcro was used again to help stiffen the structure without making it too hard. This allows the winglet to absorb impacts and come loose before damaging the rest of the aircraft.
	
\begin{figure}[H]
\centering
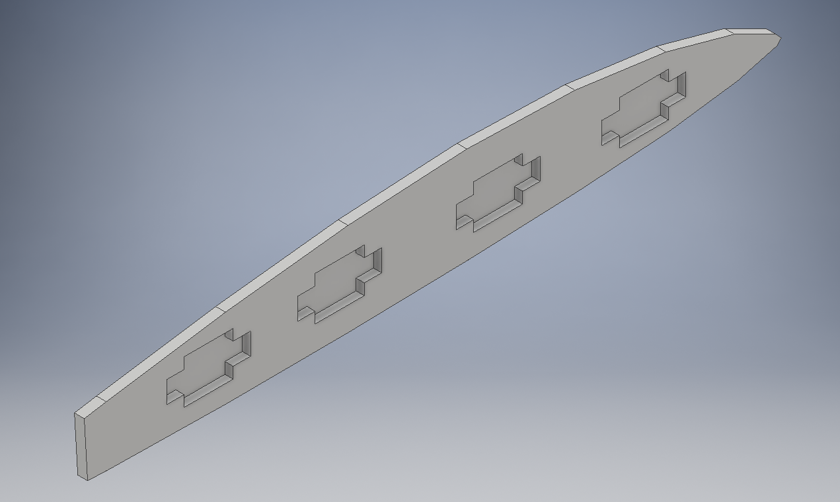
[picture p38: figs/magnetcoupler.png]
  
  \caption{3D-printed magnetic coupler.}
  \label{fig:magnetcoupler}
\end{figure}

\begin{figure}[H]
\centering
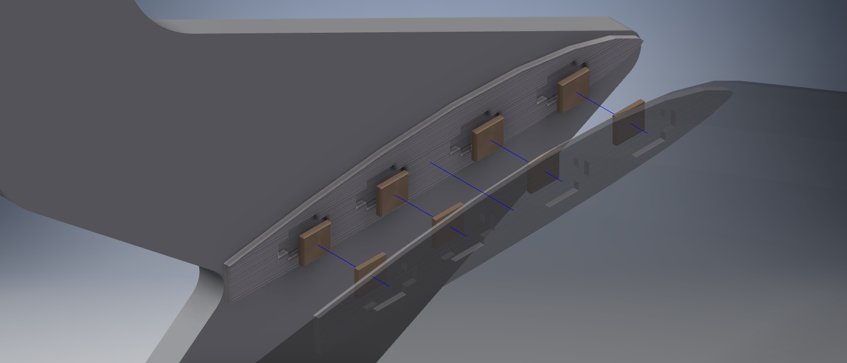
[picture p39: figs/magnetassembly.png]
  
  \caption{3D-printed magnetic coupler and winglet assembly.}
  \label{fig:magnetcoupler2}
\end{figure}

\section{Software Setup}

In order to use the ArduPilot software stack to control a tailsitter, some setup is necessary. First the regular ArduPilot setup:
\begin{itemize}
\item Frame Type Configuration: Frame Type Configuration: The kind of aircraft frame needs to be chosen: in this case it is a tail sitter. This sets up the initial parameters and controllers, as well as output mixers.

\item Compass Calibration: This step performs a calibration of the three magnetometers present in the board. Calibrated magnetometers are important for precise heading readings.

\item Radio Control Calibration: This recognizes the PWM ranges sent by the radio, so the flight controller knows when to arm/disarm, or apply full throttle.
\item Accelerometer Calibration: This step calibrates the accelerometer. As the Pixhawk might not be leveled on the frame, calibrating the accelerometers is important to know the aircraft's real orientation.
\item ESC Calibration: Just like the flight controller, the ESCs also need to know the full range of the PWM received from the Pixhawk, and thus need calibration;
\end{itemize}

After the basic setup, additional changes need to be done on the parameter level:
\begin{itemize}
\item AHRS\_EKF\_TYPE = 3 This makes the flight controller use an extended Kalman Filter that takes into consideration the accelerometer for translations, not only orientations.

\item ARMING\_CHECK,230 A custom pre-flight check is done, disabling the GPS checks due to the problems reported in \ref{badgps}.

\item SCHED\_LOOP\_RATE = 300 This makes the Kalman filter update at 300 Hz, important for faster responses on multirotor-like aircraft, like this one in VTOL mode.

\item SERVO3\_FUNCTION = 73, SERVO4\_FUNCTION = 74 This sets outputs 3 and 4 to output the mixers of left motor and right motor on a dual-motor tail sitter aircraft.

\end{itemize}

%\section{Control Tuning}

\section{Troubleshooting}

This section details some of the problems faced during this work and how each of them was handled.

\subsection{The Electronic Speed Controllers Do Not Work}
With The hardware setup, it was noted that the ESCs did not respond to the flight controllers. This could be due to two main reasons:
\begin{itemize}
\item The ESCs are unable to cope with the 400Hz PWM \footnote{Pulse Width Modulation} signal generated by the flight controller;
\item The signal voltage was not high enough;
\end{itemize}

The ESCs did answer properly to a 50Hz signal, so they were working.
%
It was later found on the DiyDrones\cite{diydronesesc} forum that the ESCs are incompatible with the Pixhawk controller, and two components had to be removed for them to work.
%
Upon further inspection, the components were noticed to be a resistor and a capacitor. This is a strong indication of an RC filter. The presence of an RC filter on the inputs, coupled with the output resistance present in most flight controllers signal outputs, resulted in a resistive divider, as seem in figure \ref{fig:divider}.
This effectively lowered the voltage read on the microcontroller to 2, as seen in figure \ref{fig:lowvoltage}.
Further inspection showed that only one 512 (5100 $\Omega$) resistor was present on the board, and it was, along with a capacitor, bridging a route to ground.
The removal of these components was enough to raise the read signal value to 3.4 V, solving the issue, as seem in figure \ref{fig:highvoltage}.

With the ESCs accepting their input signals, they needed calibration. The calibration of an RC ESC is a process where it learns the high and low bounds on its input signals. The ESC is turned on with the maximum possible input, it beeps, and the signal can be lowered to the minimum, then it beeps again.

\begin{figure}[H]
\centering
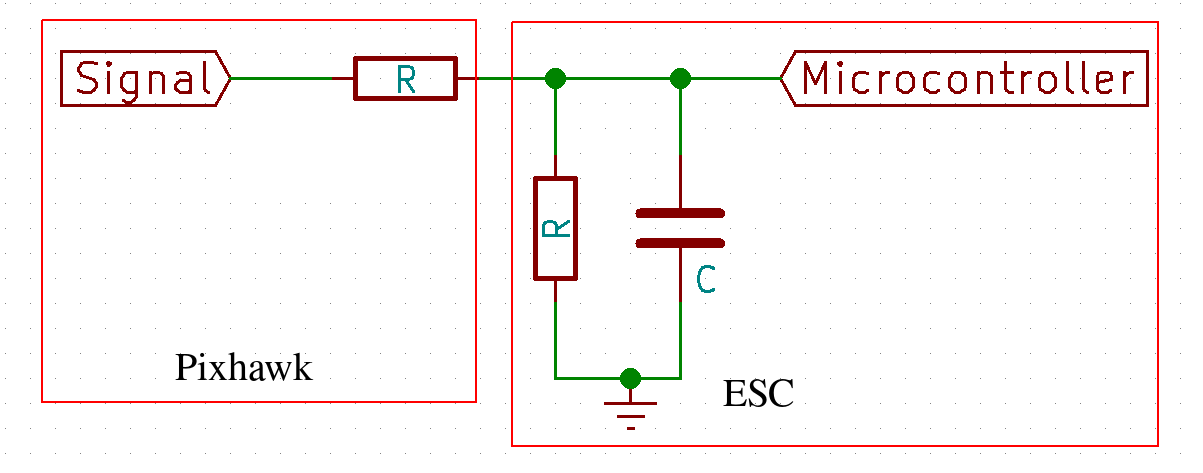
[picture p40: figs/divider.png]
  
  \caption{Schematic of signal path between Pixhawk and ESC.}
  \label{fig:divider}
\end{figure}
	
\begin{figure}[H]
\centering
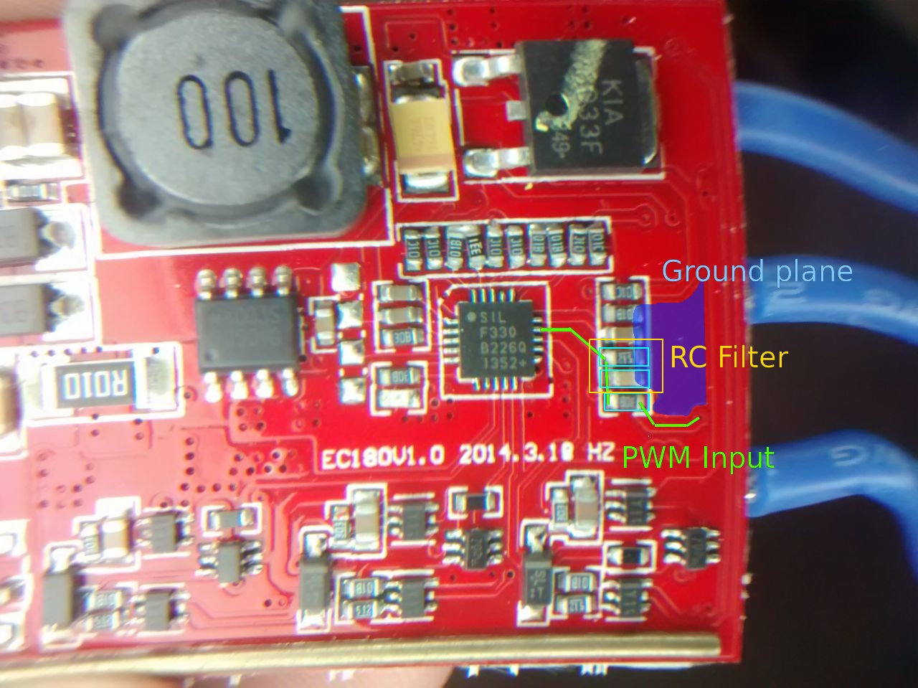
[picture p41: figs/escbeforeschematic.jpg]
  
  \caption{Schematic overlaid on ESC board.}
  \label{fig:divider2}
\end{figure}

\begin{figure}[H]
\centering
\begin{subfigure}{.5\textwidth}
  \centering
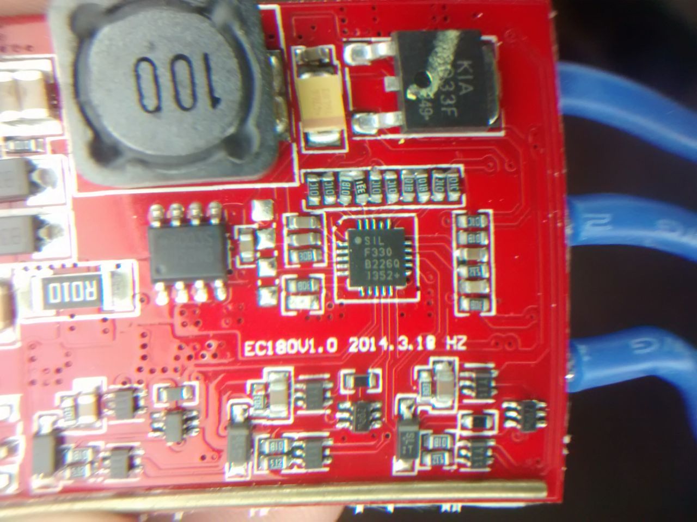
[picture p42: figs/escbefore.jpg]
  
\caption{ESC before modification.}
\end{subfigure}%
\begin{subfigure}{.5\textwidth}
  \centering
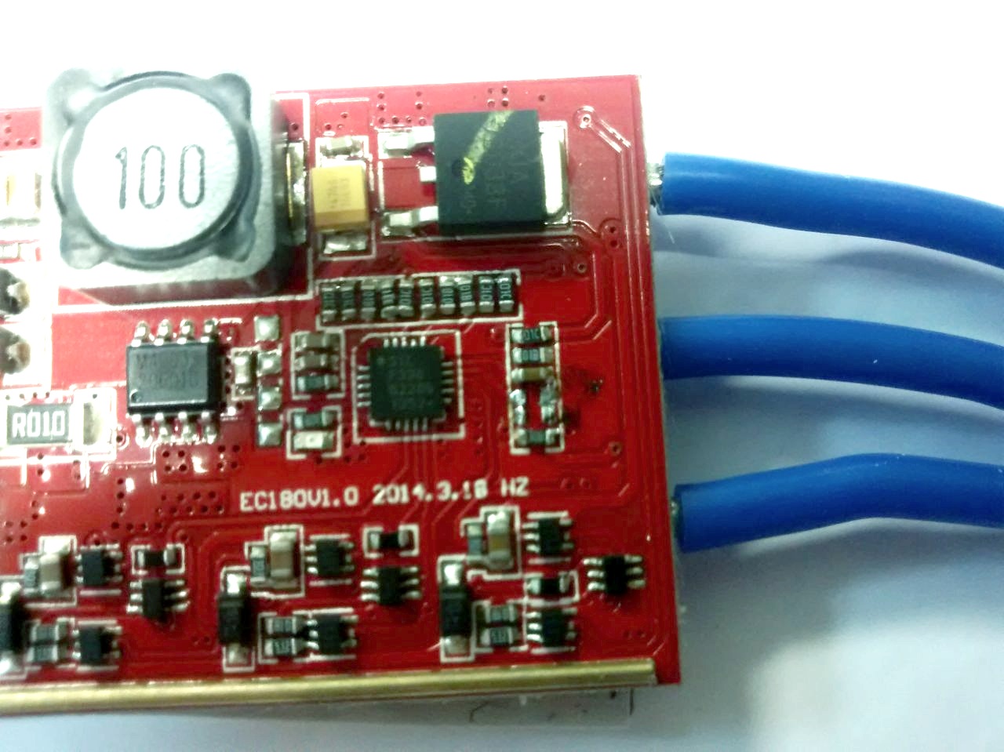
[picture p43: figs/escafter.jpg]
  
  \caption{ESC after modification.}
\end{subfigure}

\begin{subfigure}{.5\textwidth}
  \centering
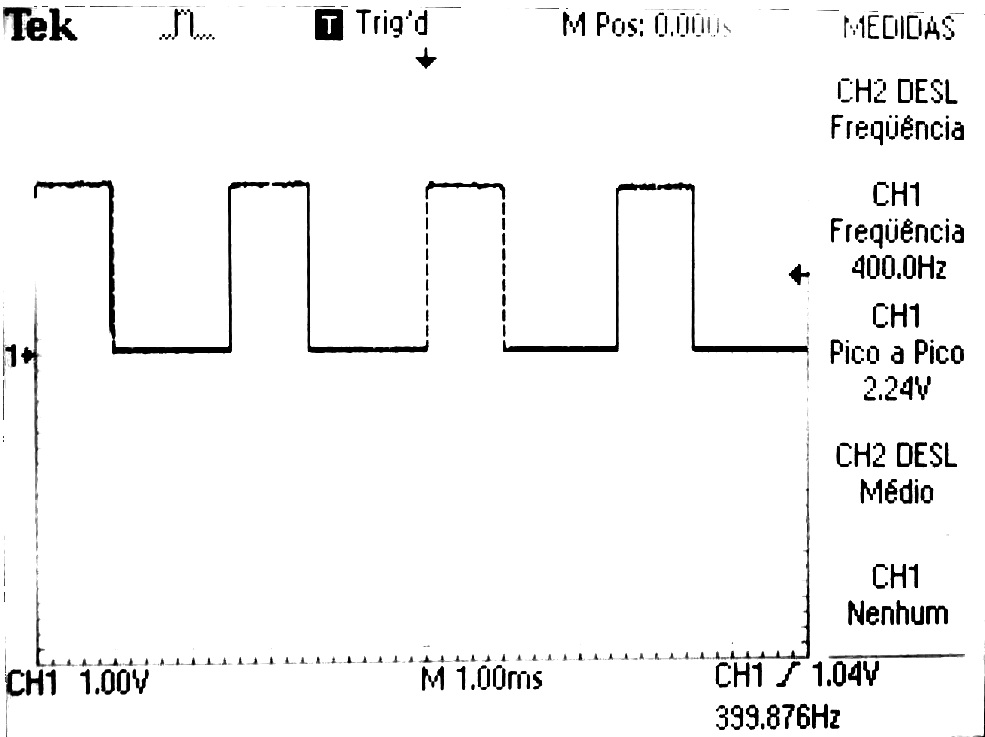
[picture p44: figs/sinalruim.jpg]
  
  \caption{Signal before modification.}
  \label{fig:lowvoltage}
\end{subfigure}%
\begin{subfigure}{.5\textwidth}
  \centering
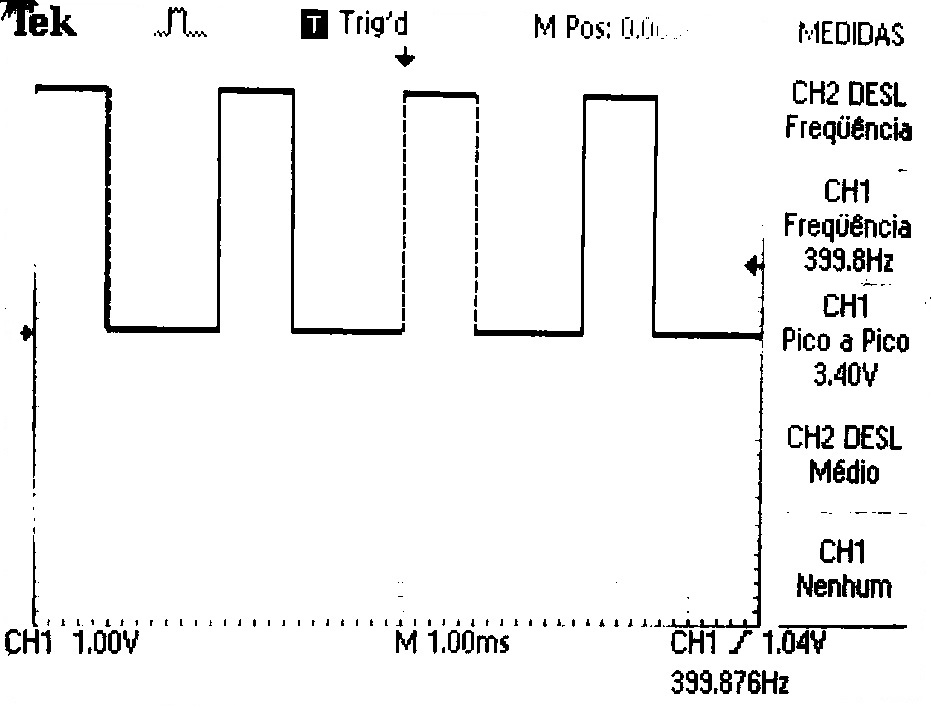
[picture p45: figs/sinalbom.jpg]
  
  \caption{Signal after modification.}
    \label{fig:highvoltage}
\end{subfigure}

\caption{Modifications on the ESC.}
\label{fig:neldermeadsteps}
\end{figure}

\subsection{The Elevons Have a High Frequency Pitch oscillation}
Even on the ground, activating the stabilization control resulted in increased high-frequency oscillations of the control surfaces on the pitch direction.
%
Any minor servo correction caused a small movement on the aircraft body, due to moment conservation. 
%
This movement is detected and, when trying to compensate, the behavior repeated, until the oscillation peaked with the maximum amplitude reachable by the servos.
%
This behavior was linked to the derivative terms on the pitch controllers.
%
Since, as seem on picture \ref{fig:roll_loop}, the roll and pitch controls are attenuated with the throttle, this effect is not present during flight. This effect should bediydrones handled in software in the future, but was not prejudicial to the tests in this project.

\subsection{Bad GPS Health}
\label{badgps}
The GPS used, even though recognized by the flight controller, made it show "Bad GPS Health messages". Further research showed that the board was a badly manufactured clone\cite{badgps}, where the wrong version of the EEPROM chip was used, with a different pinout, meaning that while the flight controller was able to communicate and setup the GPS, it was unable to perform a warm start, which is looking for the right satellites using its last known position saved on the EEPROM.

This issue has three possible solutions:
\begin{itemize}
\item Unsolder the chip and resolder to the right connections with wires.
\item Replace the chip with the correct one.
\item Replace the whole GPS with a working one.
\end{itemize}

The latter was chosen as there was a spare one available, requiring only re-wiring.
