Williangalvani/pfc/folhaaprova.tex

% ---
% Inserir folha de aprovação
% ---

% Isto é um exemplo de Folha de aprovação, elemento obrigatório da NBR
% 14724/2011 (seção 4.2.1.3). Você pode utilizar este modelo até a aprovação
% do trabalho. Após isso, substitua todo o conteúdo deste arquivo por uma
% imagem da página assinada pela banca com o comando abaixo:
%
% \includepdf{folhadeaprovacao_final.pdf}
%
\begin{folhadeaprovacao}

\thispagestyle{empty}

{\large Banca Examinadora:}

\vspace{1.3cm}

\begin{flushright}

{\large João Marcelo Corrêa}

{\large Orientador na Empresa}

\vspace{1.2cm}
%\begin{espacosimples}
{\large Prof. Ubirajara Franco Moreno}

{\large Orientador no Curso}
%\end{espacosimples}

\vspace{1.2cm}
 
%\begin{espacosimples}
{\large Prof. Hector Bessa Silveira}

{\large Responsável pela disciplina}
%\end{espacosimples}

\vspace{1cm}

{\large Pessoa, Avaliador}

\vspace{0.8cm}

{\large Pessoa, Debatedor}

\vspace{0.8cm}

{\large Pessoa, Debatedor}

\end{flushright}
  
\end{folhadeaprovacao}
