Williangalvani/pfc/modelocapa.tex

\begin{capa}%
\begin{center}
{\noindent}

\vspace{2.5cm}
{\noindent {\bfseries \huge A Fixed-wing UAV Capable of Vertical }} \\
{\noindent {\bfseries \huge Take-off and Landing for Aerial }} \\
{\noindent {\bfseries \huge Mapping and Photogrammetry. }} \\

\vspace{3.2cm}

{\noindent {\itshape \large Relatório submetido à Universidade Federal de Santa Catarina}}

{\noindent {\itshape \large como requisito para a aprovação da disciplina:}}

{\noindent {\itshape \bfseries \large DAS 5511: Projeto de Fim de Curso}}
 
\vspace{3cm} 
  
{\noindent {\itshape \bfseries \large Willian de Medeiros Galvani}} 

\vspace{3.2cm}

\thispagestyle{empty}

{\noindent {\itshape Florianópolis, Fevereiro de 2018}} 

\end{center}
\end{capa}
