Williangalvani/pfc/folhaderosto.tex

\begin{center}
{\noindent {\bfseries \Large A Fixed-wing UAV Capable of Vertical Take-off and Landing for Aerial Mapping and Photogrammetry.}}

\vspace{1.5cm}

{\noindent {\itshape \bfseries \large Willian de Medeiros Galvani}}

\vspace{1cm}

%\begin{espacosimples}
{\noindent {\large Este relatório foi julgado no contexto da disciplina}}

{\noindent {\bfseries \large DAS 5511: Projeto de Fim de Curso}}

{\noindent {\large e aprovada na sua forma final pelo}}

{\noindent {\bfseries \large Curso de Engenharia de Controle e Automação}}

\vspace{7cm}

% UGLY FIX - FIND A DIFFERENT WAY TO DO THIS
{\noindent {\large \underline{\hspace{7cm}}}}
%/UGLY FIX

{\noindent {\itshape \bfseries \large Prof. Ubirajara Franco Moreno}}

{\noindent { Orientador \hspace{5cm}}}

%\end{espacosimples}

\end{center}

\vspace{-0.2cm}
