Williangalvani/pfc/citacoes.tex

citacoes

NASCIMENTO, J. M. A., Simulador Computacional para Poços de Petróleo com
Método de Elevação Artificial por Bombeio Mecânico. Tese de M. Sc. PPGEEC/UFRN, 
73
Natal, RN, Brasil, 2005. Disponível em: <http://bdtd.bczm.ufrn.br/tedesimplificado>
Acesso em: 16 ago. 2010
