Williangalvani/pfc/capa.tex

% ---
% Informações de dados para CAPA e FOLHA DE ROSTO
% ---

\titulo{Aprendizagem de máquina para apoio à tomada de decisão em vendas de varejo utilizando registros de vendas}
\autor{Felippe Schmoeller da Roza}
\local{Brasil}
\data{2016, v-1.0}
\orientador{Orientador}
\coorientador{coorientador}
\instituicao{%
  Universidade Federal de Santa Catarina
  \par
  Departamento de Automação e Sistemas
  }
\tipotrabalho{Projeto de Fim de Curso}
% O preambulo deve conter o tipo do trabalho, o objetivo, 
% o nome da instituição e a área de concentração 
\preambulo{O preambulo deve conter o tipo do trabalho, o objetivo, o nome da instituição e a área de concentração }
% ---
