Williangalvani/pfc/cap3.pdf

??????

X =
(x1, ..., xn+1)
f(x1) ≤
f((x2) ≤
- · · ≤
f(xn+1)
x0
(x1, ..., xn+1)
xr
xr =
x0+
α(x0−
xn+1)
(Reflecção)
f(f(x1) <
f(xr) <
f(xn)
xn+1 ←
xr
(Expansão)
f(f(xr) <
f(x1)
xe =
x0+
γ(xr−
x0)
f(xe) <
f(xr)
xn ←
xe
xn ←
xr
(Contração)
xc =
x0+
ρ(xn+1−
x0)
f(xc) <
f(xn+1)
xn+1 ←
xc
(Encolhimento)
xi ←
x1+
σ(xi−
x1), i =
2 . . . n+
1
?
Mesh
Adaptative
k
Search
Poll
f(x) <
f(xk)
xkMk =

{x+
∆m
k Dz :
x ∈
Vk, z ∈
NnD} ⊂
Rn
Mk
x
∆m
k
D
Rn×nD
nD
Rn
[In−
In]
Inn
SEARCH
Surrogate
libPOLL
k
Pk =
{xk+
∆

p
k

d :
d ∈
