Williangalvani/pfc/cap5.pdf

??????sp

lpi
min
x∈Ω

f(x).

p, lpi)
Ω =
{sp ∈
R |
sp,min <
sp <
sp,max}
{lpi ∈
R |
lpi,min <
lpi <
lpi,max}
sp
lpi
f(qinj ; x)
x
qinj
θ(qinj ; x)
x
p, lpi)
=∑n

i=1 [
θ(q

n
inj ; x)−

f(q

n

inj ; x))]2

q

1
inj , q²
inj , . . . , qn
inj
pi,min =
15
lpi,max =
35sp,min =
2000 sp,max =
7000
executablecommand(

′pythonpipesimrun.py′
)
pressure =
P arameter(kind =′
real′
, def ault =
sp, bound =
(2000, 7000), name =′
sp′

, description =′
StaticP ressure′
)liqpi =
P arameter(kind =′
real′
, def ault =
pi, bound =
(15, 35), name =′
pi′

, description =′
LiqP I′
)
param(staticpressure)F D.addparam(liqpi) measure(error)
error(parameters, measures) : returnsum(measures[”ERROR”]) error)Unconstrainedmodel = Model(modelData =
data, modelStructure =
struct)
T ARGET =
0.1
??
p =
4000, 691
lpi =
24, 954
Custo =
0, 0757.
sp =
4000
lpi =
25
evalpoints.pdfP ontosescolhidospeloNOMAD. errors.pdfErronospontosavaliados. parameter(name =
”MODELSEARCH”, value =
”SGT ELIB”)
p =
4001, 389
Lpi =
24, 905
Custo =
0, 09986.
10⁶⁴
evalpoints.pdfP ontosescolhidospeloNOMAD.
