Williangalvani/pfc/figs/axis1.png

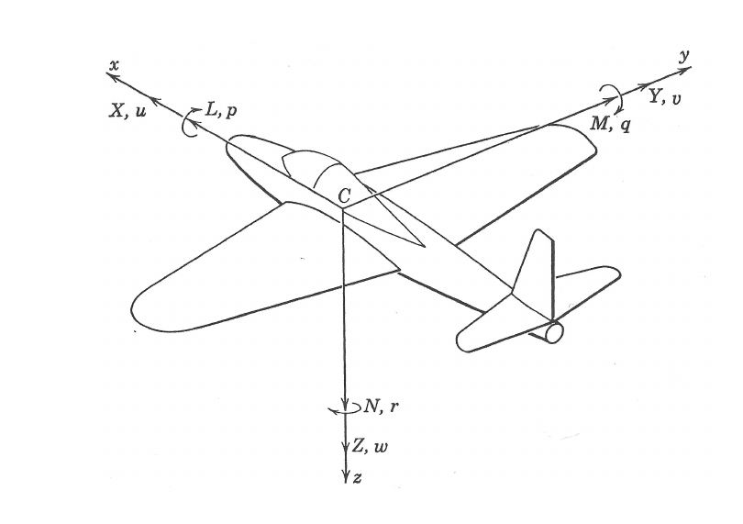
figs/axis1.png
