Williangalvani/pfc/figs/axisraw.png

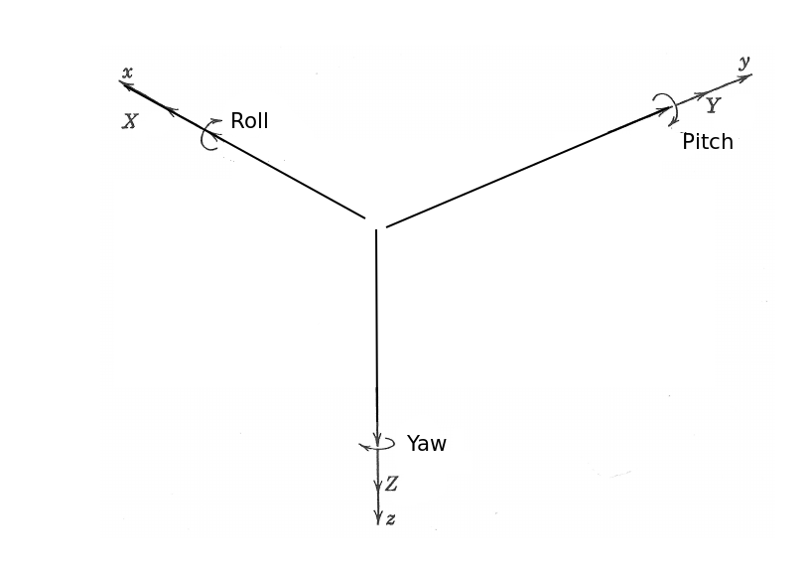
figs/axisraw.png
