Williangalvani/pfc/figs/craftpolar.png

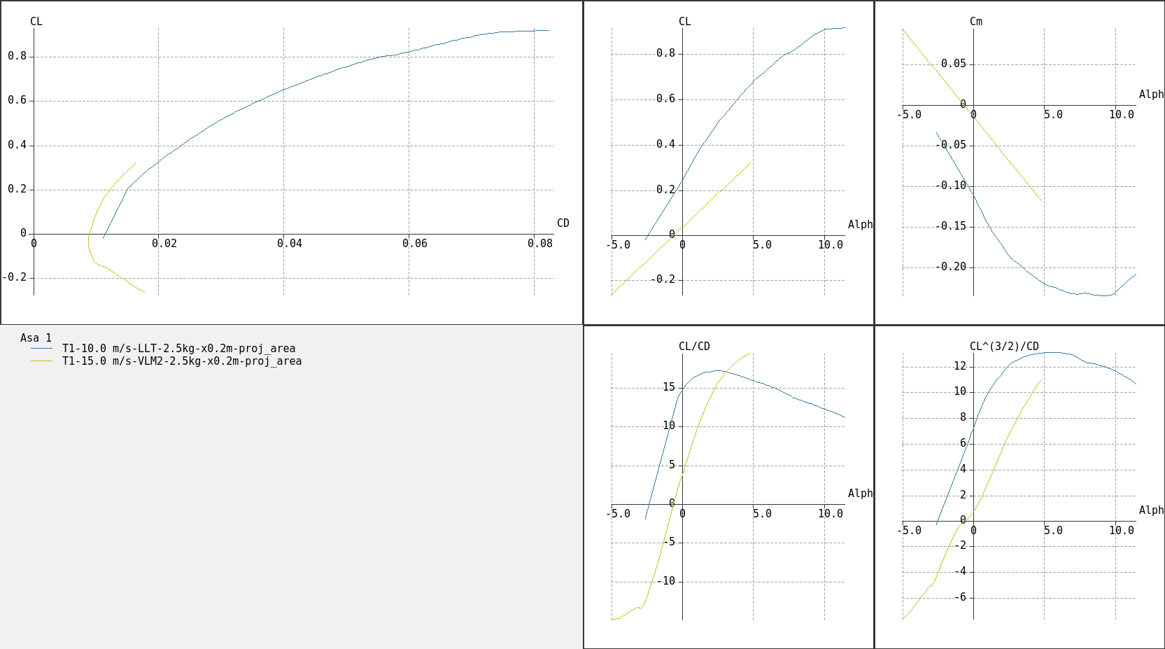
figs/craftpolar.png
