Williangalvani/pfc/figs/curve12.gif

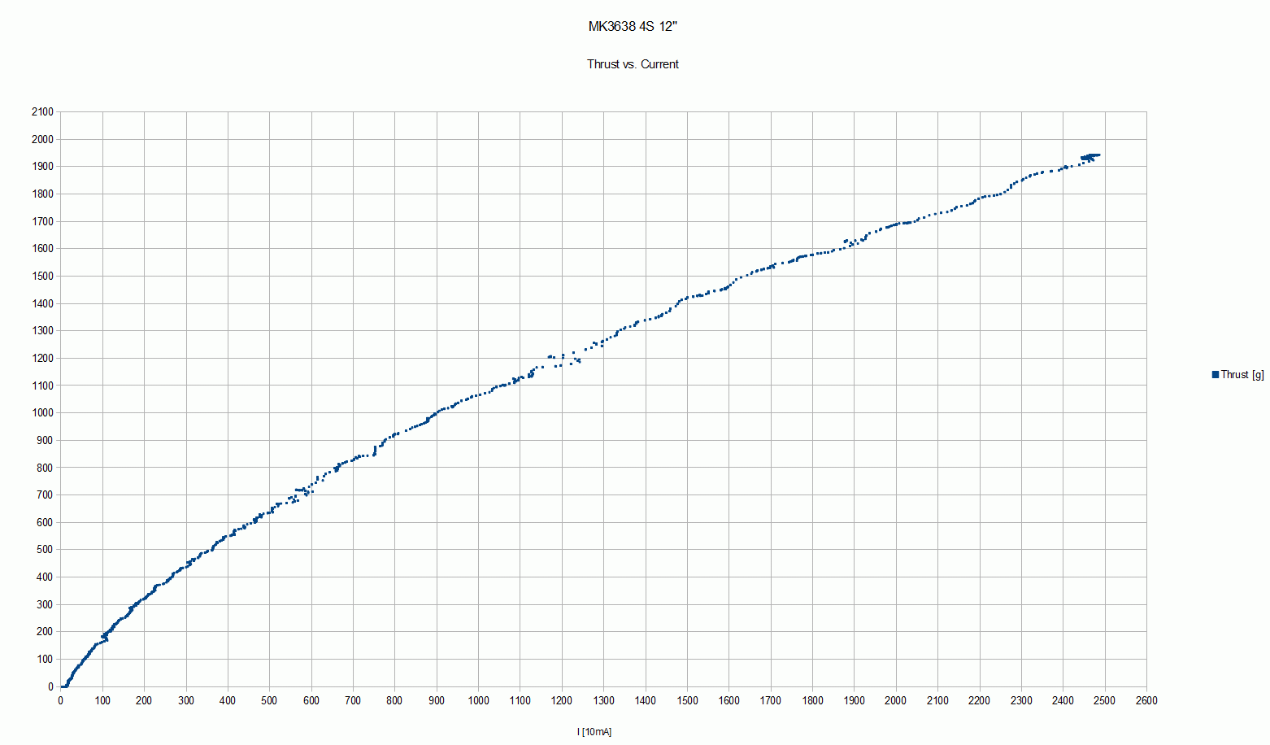
figs/curve12.gif
