Williangalvani/pfc/figs/curve15.gif

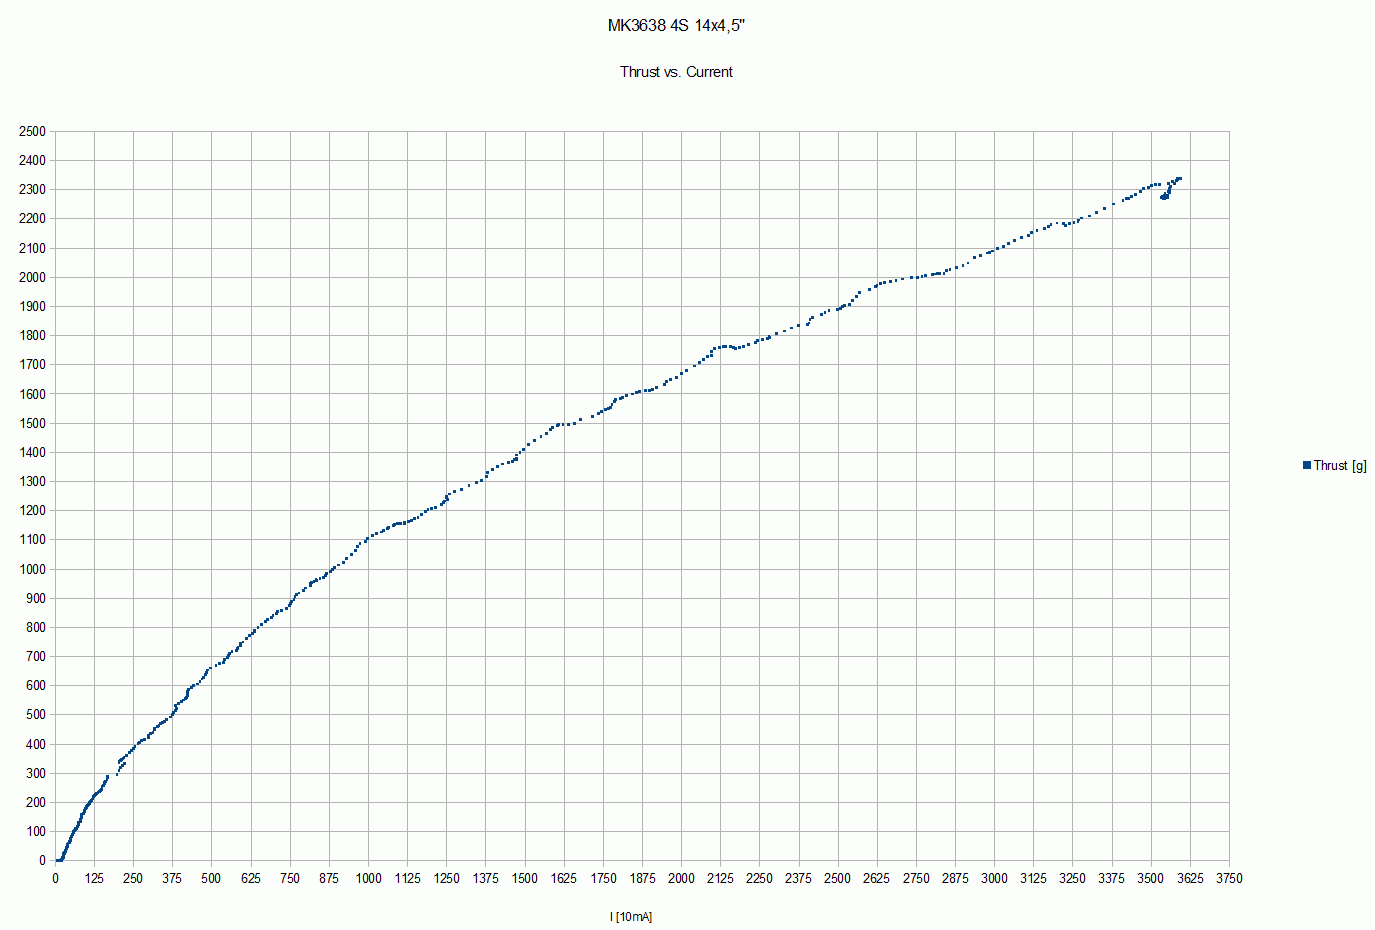
figs/curve15.gif
