Williangalvani/pfc/figs/drawing.png

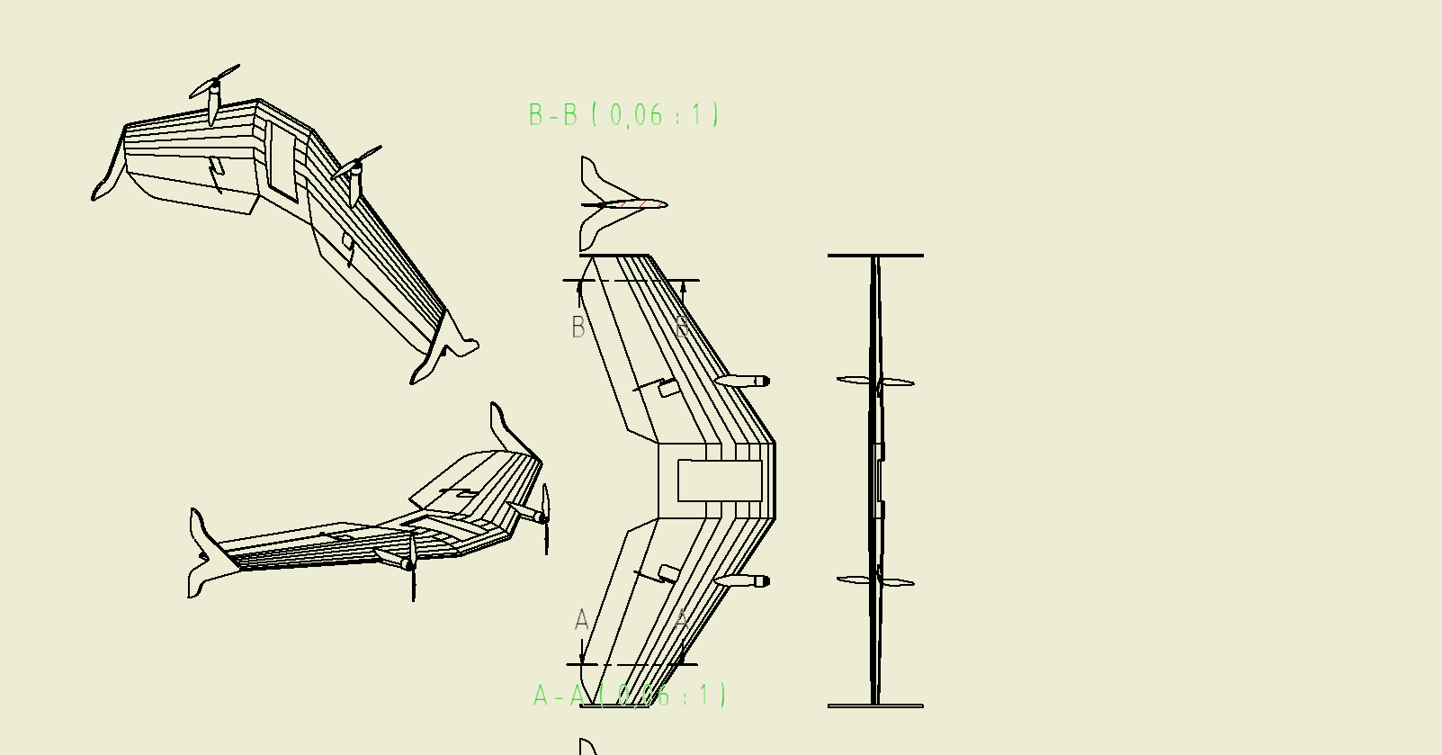
figs/drawing.png
