Williangalvani/pfc/figs/elevons.png

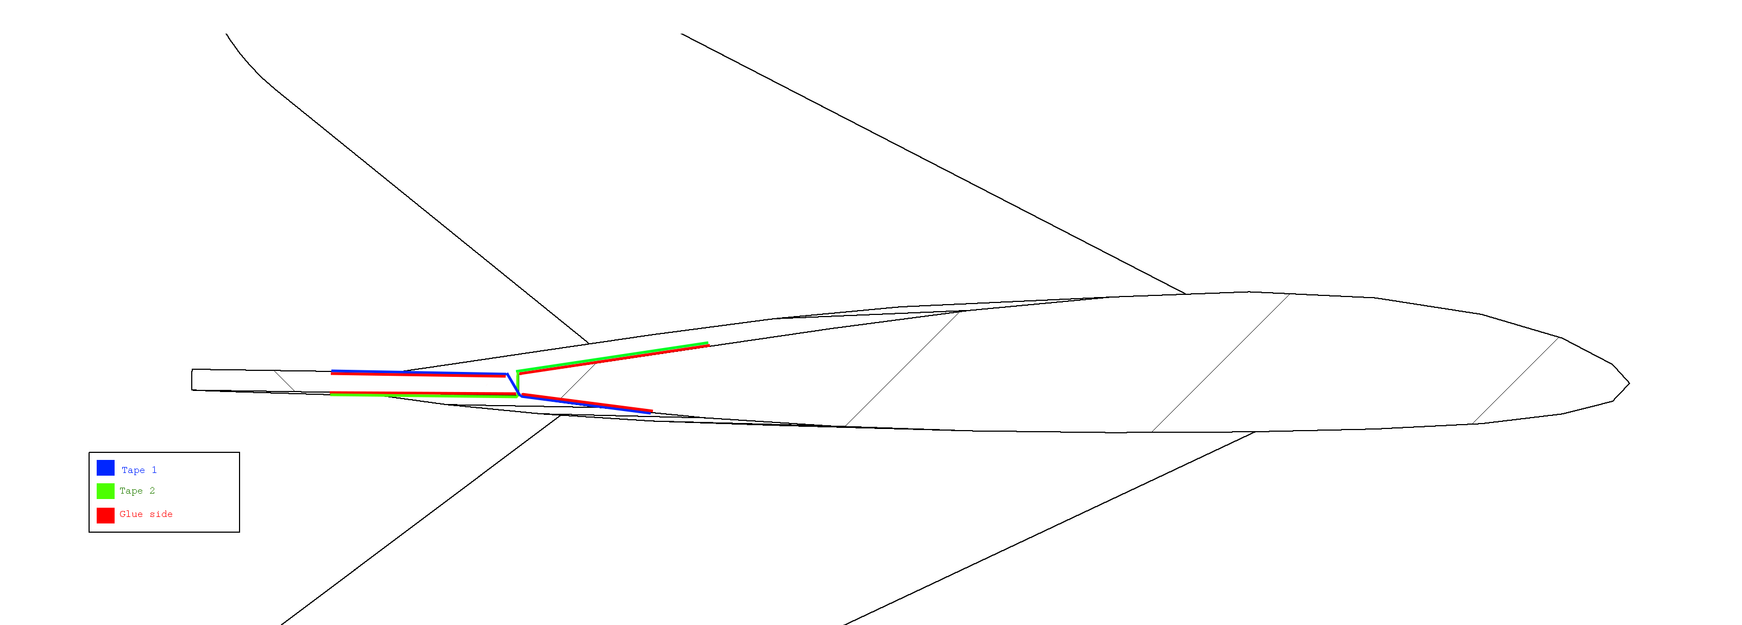
figs/elevons.png
