Williangalvani/pfc/figs/flying.png

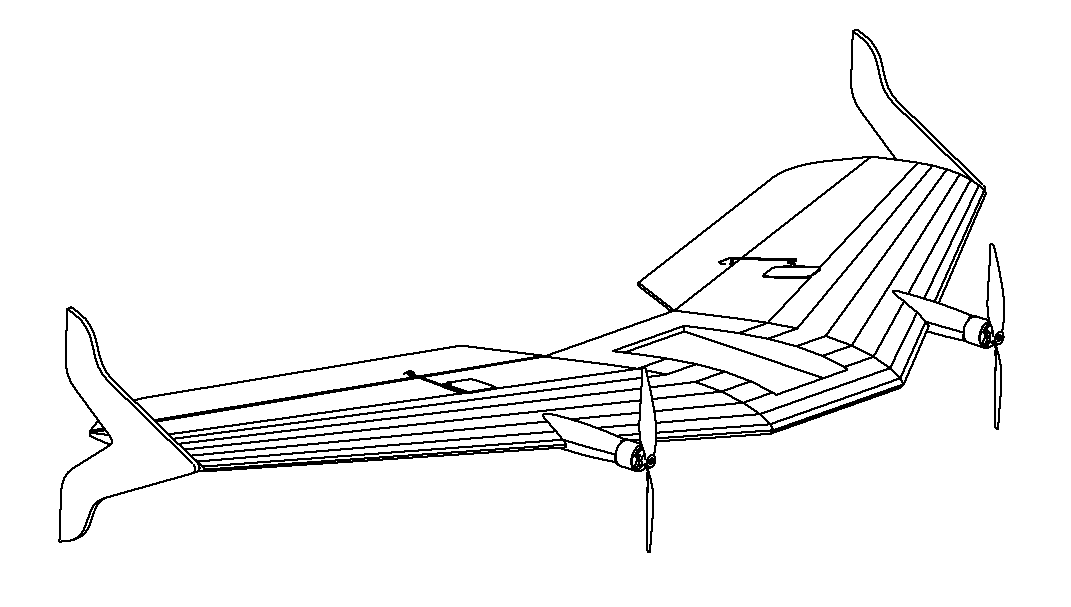
figs/flying.png
