Williangalvani/pfc/figs/hinges.png

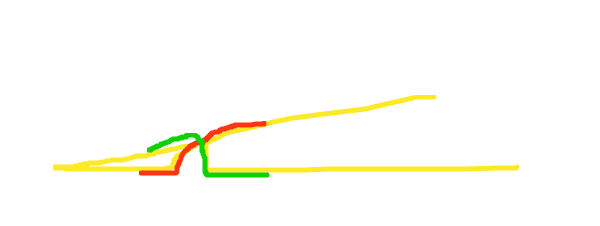
figs/hinges.png
