Williangalvani/pfc/figs/landed.png

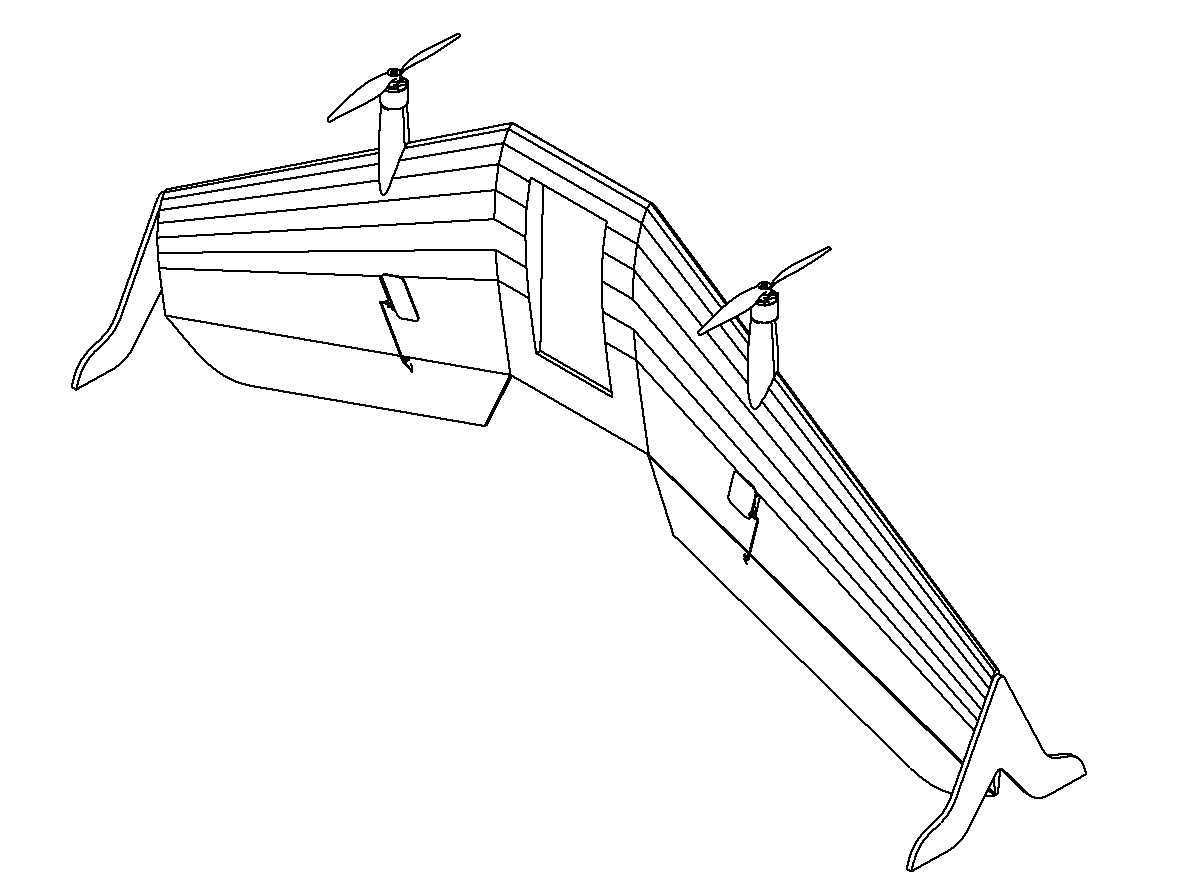
figs/landed.png
