Williangalvani/pfc/figs/motorcurves.png

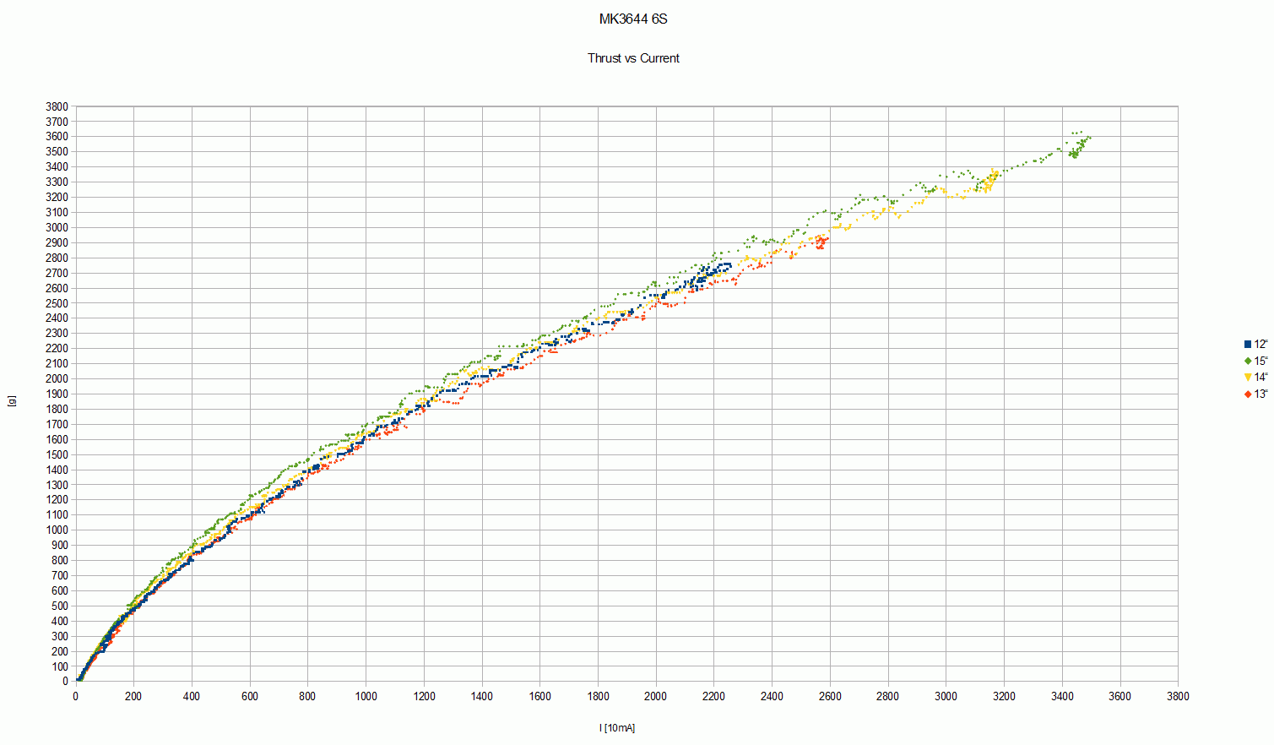
figs/motorcurves.png
