Williangalvani/pfc/figs/motormount.png

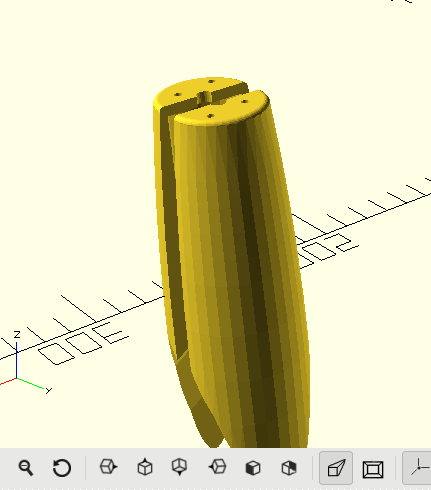
figs/motormount.png
