Williangalvani/pfc/figs/top.png

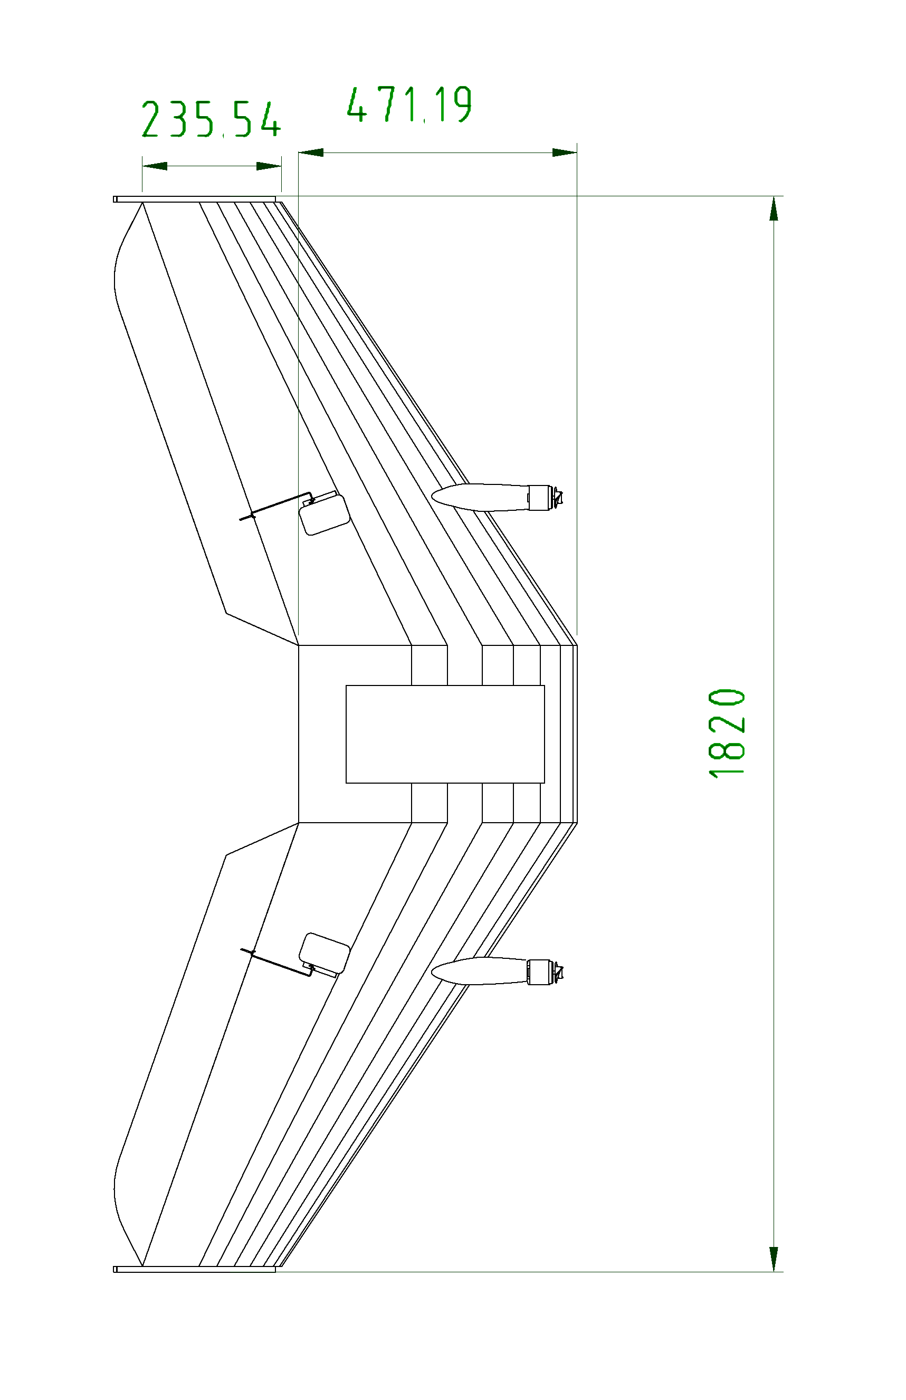
figs/top.png
