Williangalvani/pfc/figs/WhatsApp Image 2017-11-20 at 11.19.01 PM.jpeg

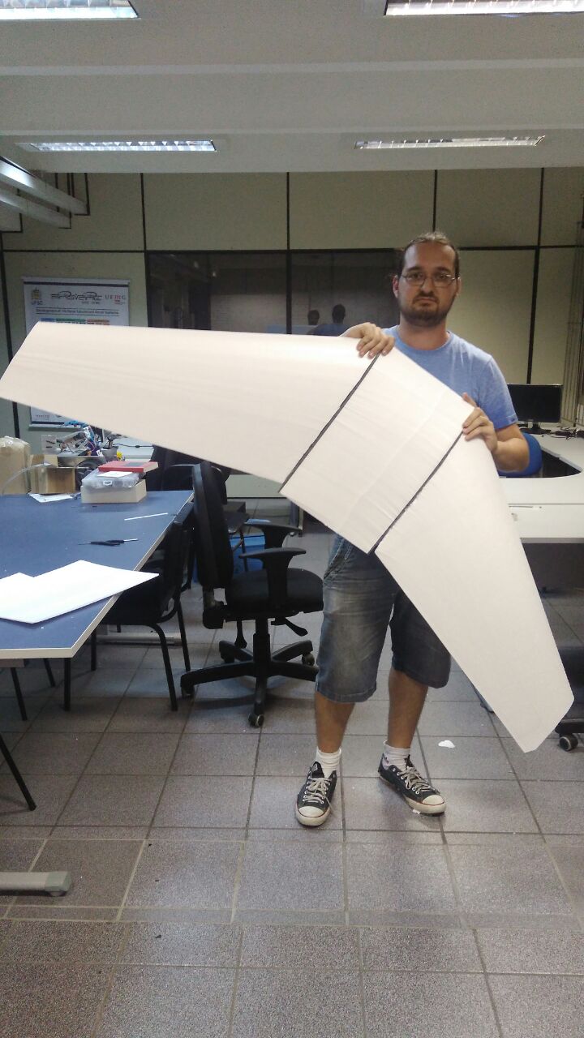
figs/WhatsApp Image 2017-11-20 at 11.19.01 PM.jpeg
