Williangalvani/pfc/figs/winglet.PNG

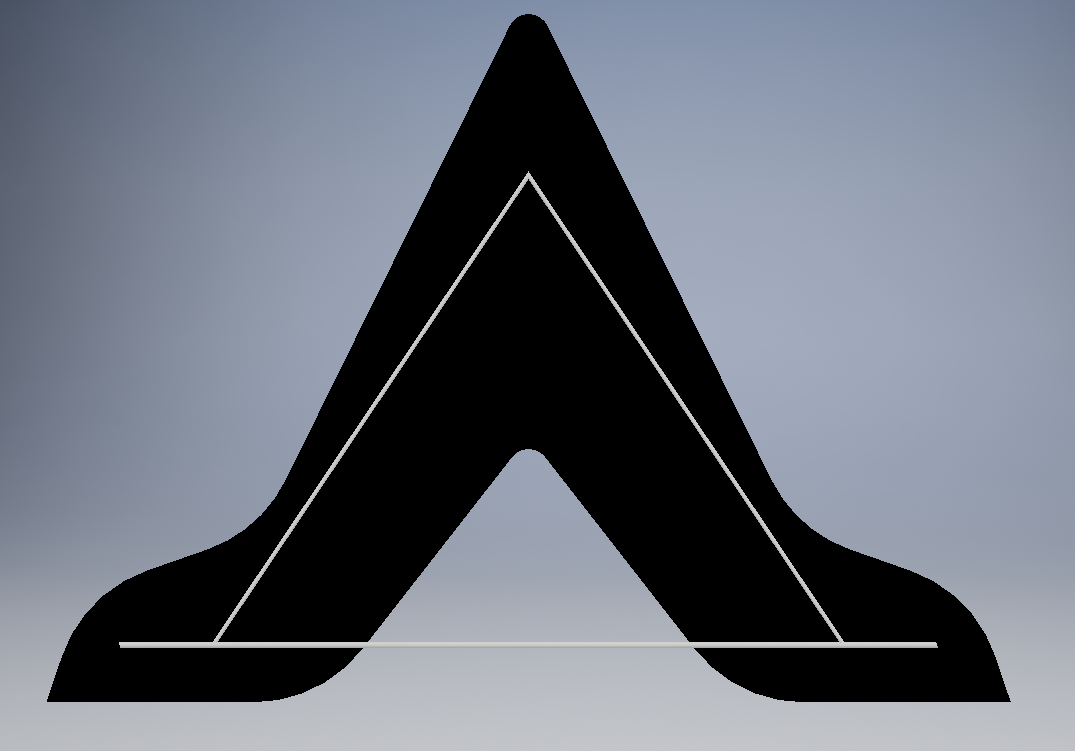
figs/winglet.PNG
