Williangalvani/pfc/projeto/Asa 1.stl

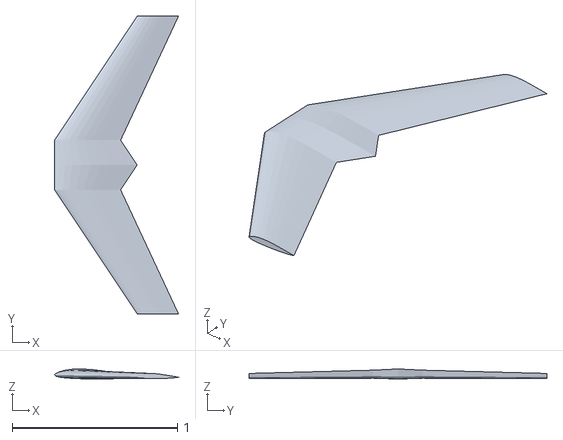
[picture p65: CAD file, 2017-11-19]
projeto/Asa 1.stl
0.75 x 1.80 x 0.0612
