Williangalvani/pfc/projeto/asa1/standardServo.stl

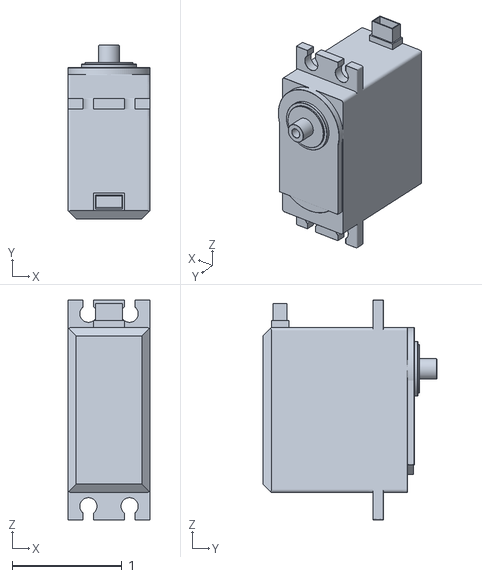
[picture p66: CAD file, 2018-01-07]
projeto/asa1/standardServo.stl
0.75 x 1.58 x 2.00
