Williangalvani/pfc/projeto/asa1/nutholderv2_clipped.stl

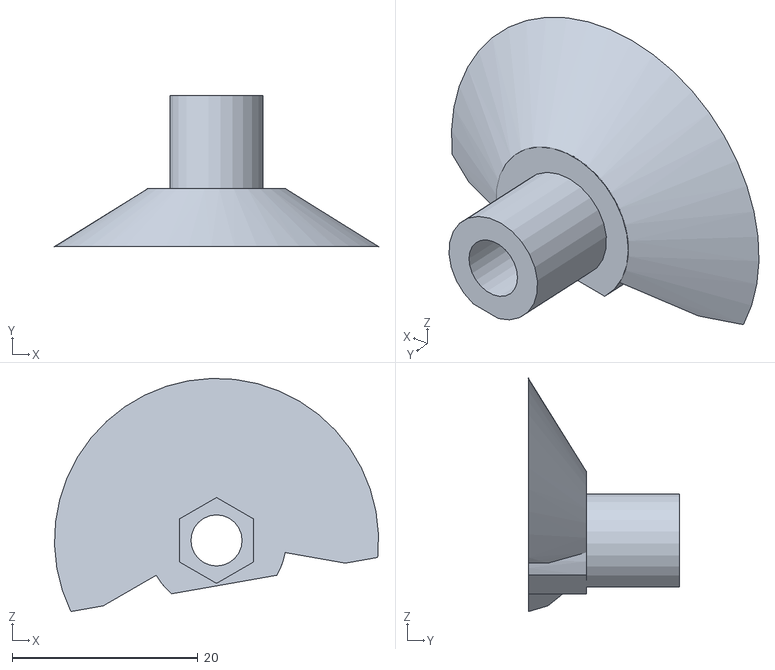
[picture p67: CAD file, 2018-01-07]
projeto/asa1/nutholderv2_clipped.stl
34.9 x 16.3 x 25.1
