Williangalvani/pfc/projeto/asa1/nutholderv2.stl

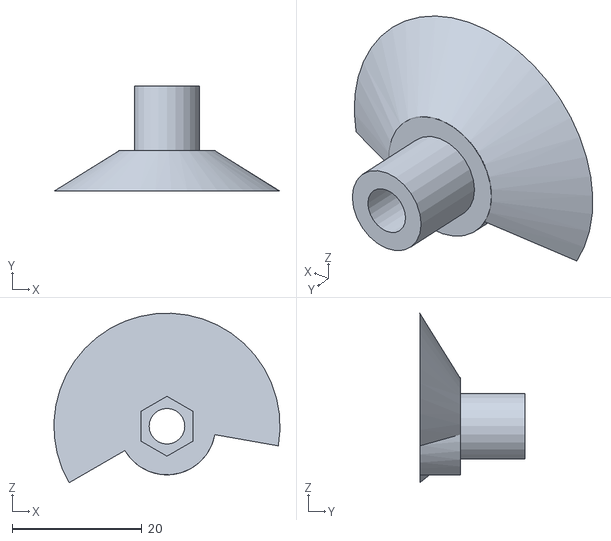
[picture p68: CAD file, 2018-01-07]
projeto/asa1/nutholderv2.stl
34.9 x 16.3 x 26.1
