Williangalvani/pfc/projeto/asa1/servomount.stl

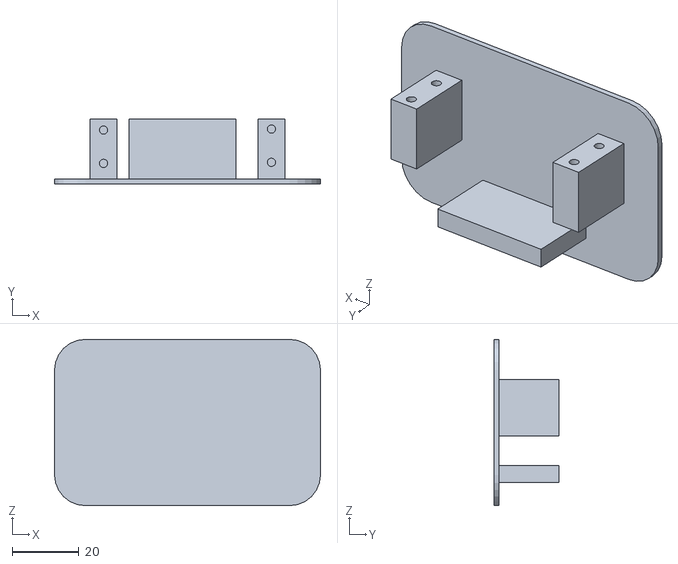
[picture p69: CAD file, 2018-01-07]
projeto/asa1/servomount.stl
80.0 x 19.5 x 50.0
