Williangalvani/pfc/projeto/asa1/VAS_Banshee_Stecter_control_horn.stl

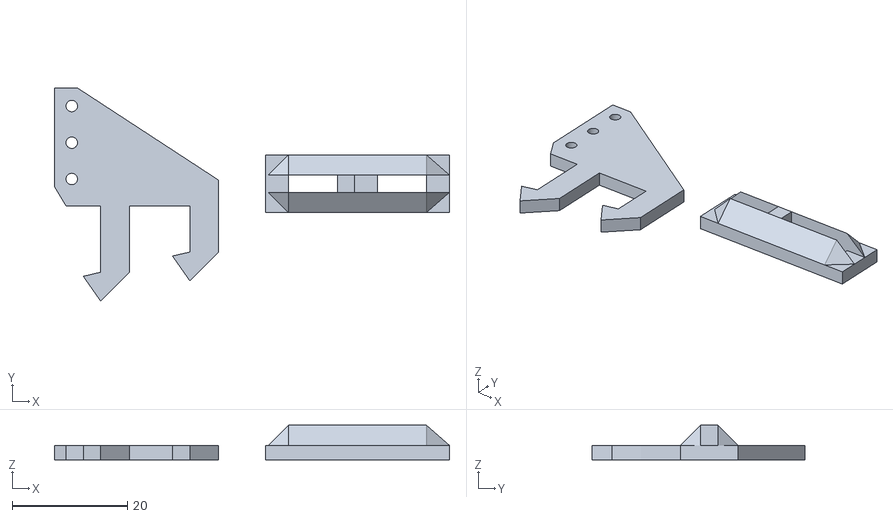
[picture p70: CAD file, 2018-01-07]
projeto/asa1/VAS_Banshee_Stecter_control_horn.stl
68.6 x 37.0 x 6.00
