Williangalvani/pfc/projeto/asa1/podsv2.stl

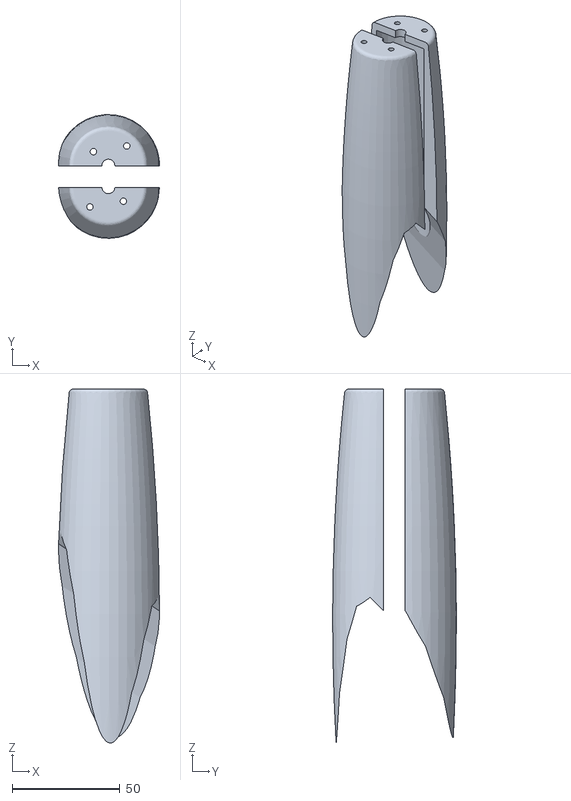
[picture p71: CAD file, 2018-01-07]
projeto/asa1/podsv2.stl
46.8 x 57.4 x 164.1
