Williangalvani/pfc/projeto/asa1/pods.stl

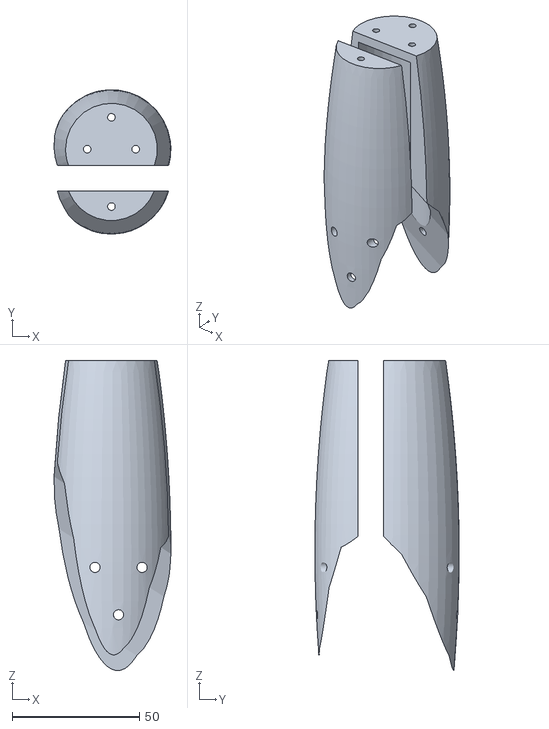
[picture p72: CAD file, 2018-01-07]
projeto/asa1/pods.stl
45.8 x 56.6 x 121.6
