Williangalvani/pfc/projeto/asa1/nutholder.stl

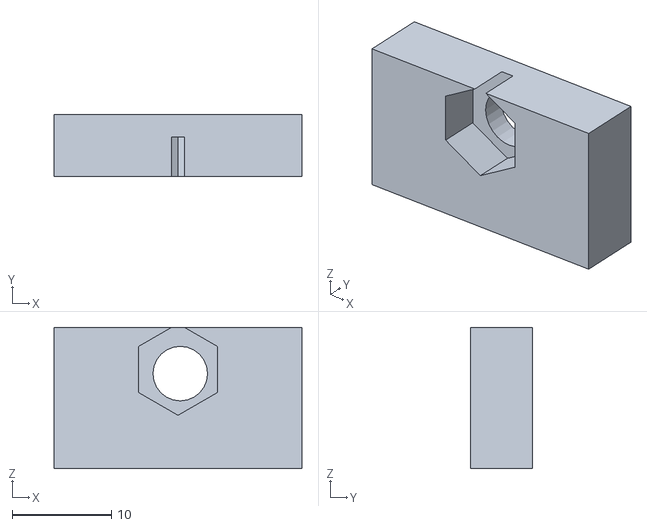
[picture p73: CAD file, 2018-01-07]
projeto/asa1/nutholder.stl
25.0 x 6.25 x 14.2
