Williangalvani/pfc/(list of files, cad)

Other CAD files:
projeto/asa1/14 x 5.CATPart
projeto/asa1/14 x 5.ipt
projeto/asa1/APC 12x6 EP Prop.ipt
projeto/asa1/ARM.ipt
projeto/asa1/ARM_MIR.ipt
projeto/asa1/Part1.ipt
projeto/asa1/Part16.ipt
projeto/asa1/Part2.ipt
projeto/asa1/Part2_MIR.ipt
projeto/asa1/Part2_open.ipt
projeto/asa1/Turnigy PROPDRIVE v2 4248 650kv.ipt
projeto/asa1/WIRE.ipt
projeto/asa1/WIRE_MIR.ipt
projeto/asa1/assembly.iam
projeto/asa1/assembly2.iam
projeto/asa1/base.ipt
projeto/asa1/capaservo.ipt
projeto/asa1/capaservo_MIR.ipt
projeto/asa1/elevon.ipt
projeto/asa1/elevon_MIR.ipt
projeto/asa1/horn.ipt
projeto/asa1/horn_MIR.ipt
projeto/asa1/nutholder.ipt
projeto/asa1/nutholderv2.ipt
projeto/asa1/nutholderv2_clipped.ipt
projeto/asa1/podsv2.ipt
projeto/asa1/suportemotor.ipt
projeto/asa1/winglet.ipt
projeto/asa1/winglet_MIR.ipt
