Williangalvani/pfc/(commit log)

2017-06-24 punctuation, aonde -> em que
2017-11-19 write about prototype
    [Asa 1.stl]
2017-11-21 further explain motor choice
2017-12-25 define the used battery
2017-12-25 Detail the servo information
2017-12-25 add details on the motors
2017-12-25 detail the hinge mechanism
2018-01-02 add magnet coupling and servo mount system
2018-01-02 talk about winglet
2018-01-04 add ESC troubleshooting
    [esc.kicad_pcb, esc.sch]
2018-01-07 detail pitch oscilations
2018-01-07 fix motor figures to place
2018-01-07 fix motor data
2018-01-07 fix motor curves
2018-01-07 add motor picture
2018-01-07 refine battery text
2018-01-07 add battery picture, typo
2018-01-07 add missing pictures, restructure chaptersC
    add gitignore
    [14 x 5.CATPart, 14 x 5.ipt, APC 12x6 EP Prop.SLDPRT, APC 12x6 EP Prop.ipt, ARM.ipt, ARM_MIR.ipt, Part1.ipt, Part16.ipt]
2018-01-07 add servo model and picture
2018-01-07 add servo specs, fix typo
2018-01-18 update motor curve images, fix wrong size, change table caption to bottom
